garvsify/Nixie-Valve-Clock/README.md

# Nixie-Valve-Clock
All files for the Nixie Valve Clock Project. Started 04/11/2025
