garvsify/Nixie-Valve-Clock/Electronic Resources and References/PCB Source Files/A.2-Release-(A.1-with-changes-documentation)/Nixie Valve Clock-A.2/SRC-Nixie Valve Clock-A.2/Eurocircuits Class Calculator and Design Rule Generator.xlsx

 |  |  |  |  | Eurocircuits Classifications
User Guide |  |  |  |  | Pattern Class | MUAR (mm)(Minimum of MUOAR/MUIAR) | MTW (mm) | MTT/MTP/MPP (mm)
 |  |  |  |  | 3 | 0.2 | 0.25 | 0.25
Enter MPS, PTH/NPTH, and MFHS into the green-outlined cells to calculate Pattern and Drill Classes |  |  |  |  | 4 | 0.15 | 0.2 | 0.2
 |  |  |  |  | 5 | 0.15 | 0.175 | 0.175
 |  |  |  |  | 6 | 0.125 | 0.15 | 0.15
Note: The minimum hole-to-hole clearances listed in the 'Altium Design Rule Generator' are essentially exception rules if the minimum pad-to-pad and minimum annular ring rules are broken. I.e. if the annular rings are shrunk below the minimum (this is legal in certain cases, see Eurocircuits website) then this is where the minimum hole-to-hole clearance becomes relevant |  |  |  |  | 7 | 0.125 | 0.125 | 0.125
 |  |  |  |  | 8 | 0.125 | 0.1 | 0.1
 |  |  |  |  | 9 | 0.1 | 0.09 | 0.09
 |  |  |  |  | Drill Class | MTS (mm)
Glossary |  | Equations |  |  | A | 0.6
MTS | Minimum Toolsize | If PTH: |  |  | B | 0.45
MUAR | Minimum Unfinished Annular Ring | MFAR = MUAR + (0.1/2)mm |  |  | C | 0.35
MUIAR | Minimum Unfinished Inner Annular Ring |  |  |  | D | 0.25
MUOAR | Minimum Unfinished Outer Annular Ring | If NPTH: |  |  | E | 0.2
MTW | Minimum Track Width | MFAR = MUAR
MTT | Minimum Track-to-Track Clearance |  |  |  | Minimum Class Calculator
MTP | Minimum Track-to-Pad Clearance | If PTH:
MPP | Minimum Pad-To-Pad Clearance | MFHS = MTS - 0.1mm |  |  | Minimum Pattern Class:
MUHH | Minimum Unfinished Hole-to-Hole Clearance |  |  |  | Note: PTH will require a smaller (higher number) Pattern class due to the larger toolsize compared with NPTH, therefore advice is to plug in your smallest PTH characteristics to find your minimum Pattern Class. However because for the same MFHS, NPTH will require a smaller toolsize, if you are using NPTH in your design, and the NPTH MFHS less than or equal to the PTH MFHS, remember to plug these values in to find the smallest Drill Class in your project
MFHH | Minimum Finished Hole-to-Hole Clearance | If NPTH:
MFAR | Minimum Finished Annular Ring | MFHS = MTS |  |  | Enter MPS required | Enter PTH/NPTH | Enter MFHS required | (Calculated Ideal MUAR) | (Calculated Nearest Class MUAR) | (Calculated MFAR in calculated class) | Calculate Minimum Pattern Class
MFHS | Minimum Finished Hole Size |  |  |  | 0.8 | PTH | 0.4 | 0.15 | 0.15 | 0.2 | 4
MTS | Minimum Toolsize
MPS | Minimum Padsize |  |  |  | Minimum Drill Class:
PTH | Plated Through Hole |  |  |  | PTH/NPTH | MFHS | (Calculated Ideal MTS) | (Calculated Nearest Class MTS) | Calculate Minimum Drill Class
NPTH | Non-Plated Through Hole |  |  |  | PTH | 0.4 | 0.5 | 0.45 | B
 |  |  | Rules generated for Class: |  | Altium Design Rule Generator (from Calculator)
 |  |  | 4 | B | Note: You may have to create new rules
 |  |  |  |  | Design Rule Location | Design Rule | Amount (mm)
 |  |  |  |  | Electrical > Clearance | Minimum Clearance | 0.2
 |  |  |  |  | Electrical > Clearance | Clearance_IPI | 0.225
 |  |  |  |  | Routing > Width | Minimum Width | 0.2
 |  |  |  |  | Routing > Routing Via Style | Routing Vias | *
 |  |  |  |  | Mask > Solder Mask Expansion | Solder Mask Expansion | 0.04
 |  |  |  |  | Mask > Paste Mask Expansion | Paste Mask Expansion | 0
 |  |  |  |  | Manufacturing | PTH Minimum Annular Ring (PTH MFAR) | 0.2
 |  |  |  |  | Manufacturing | NPTH Minimum Annular Ring (NPTH MFAR) | 0.15
 |  |  |  |  | Manufacturing | Minimum Hole Size PTH (PTH MFHS) | 0.4
 |  |  |  |  | Manufacturing | Minimum Hole Size NPTH (NPTH MFHS) | 0.5
 |  |  |  |  | Manufacturing | Minimum Hole to Hole Clearance | 0.35
 |  |  |  |  | Manufacturing | Minimum Soldermask Sliver | 0.08
 |  |  |  |  | Manufacturing | Silk to Soldermask Clearance | 0
 |  |  |  |  | Manufacturing | Silk to Silk Clearance | 0.15
 |  |  |  |  | Manufacturing | Board Outline Clearance** | 0.4
 |  |  |  |  | * Set your minimum characteristics for the routing vias to the MPS and MFHS, set the pref. and max. relevant to your own projwct requirements
 |  |  |  |  | ** As The board outline is intepreted as an 'object' the actual Board outline clearance will be the largest of the Board Outline Clearance Rule and a specific region to the board outline region (controlled from the clearance rules), so make sure your clearance rule accounts for this placing regions up to the board outline
 |  |  | Enter Class: |  | Altium Design Rule Generator (Manual Class Selection)
 |  |  | 9 | D | Note: You may have to create new rules
 |  |  |  |  | Design Rule Location | Design Rule | Amount (mm)
 |  |  |  |  | Electrical > Clearance | Minimum Clearance | 0.09
 |  |  |  |  | Electrical > Clearance | Clearance_IPI | 0.2
 |  |  |  |  | Routing > Width | Minimum Width | 0.09
 |  |  |  |  | Routing > Routing Via Style | Routing Vias | *
 |  |  |  |  | Mask > Solder Mask Expansion | Solder Mask Expansion | 0.04
 |  |  |  |  | Mask > Paste Mask Expansion | Paste Mask Expansion | 0
 |  |  |  |  | Manufacturing | PTH Minimum Annular Ring (PTH MFAR) | 0.15
 |  |  |  |  | Manufacturing | NPTH Minimum Annular Ring (NPTH MFAR) | 0.1
 |  |  |  |  | Manufacturing | Minimum Hole Size PTH (PTH MFHS) | 0.15
 |  |  |  |  | Manufacturing | Minimum Hole Size NPTH (NPTH MFHS) | 0.25
 |  |  |  |  | Manufacturing | Minimum Hole to Hole Clearance | 0.35
 |  |  |  |  | Manufacturing | Minimum Soldermask Sliver | 0.08
 |  |  |  |  | Manufacturing | Silk to Soldermask Clearance | 0
 |  |  |  |  | Manufacturing | Silk to Silk Clearance | 0.15
 |  |  |  |  | Manufacturing | Board Outline Clearance** | 0.4
 |  |  |  |  | * Minimum characteristics for vias/pads can be derived from other rules
 |  |  |  |  | ** As The board outline is intepreted as an 'object' the actual Board outline clearance will be the largest of the Board Outline Clearance Rule and a specific region to the board outline region (controlled from the clearance rules), so make sure your clearance rule accounts for this placing regions up to the board outline
