garvsify/Nixie-Valve-Clock/Cathode Poisoning/Screenshot 2025-11-05 at 15.28.37.png

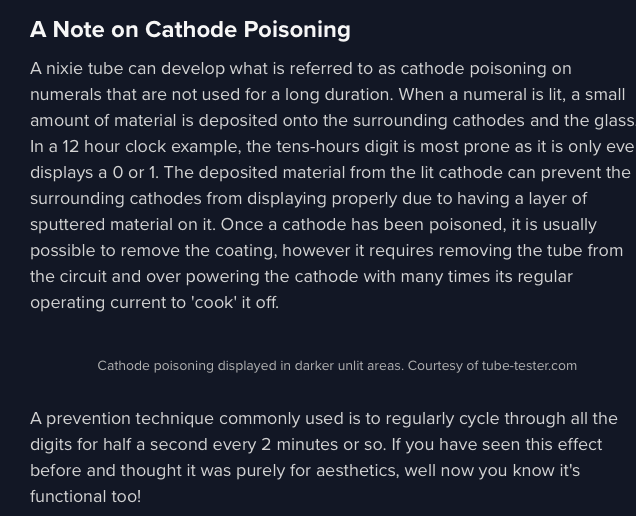
Cathode Poisoning/Screenshot 2025-11-05 at 15.28.37.png
