garvsify/Nixie-Valve-Clock/Electronic Resources and References/IN-35 Nixie Tube Resources/IN-35 eBay listing details.png

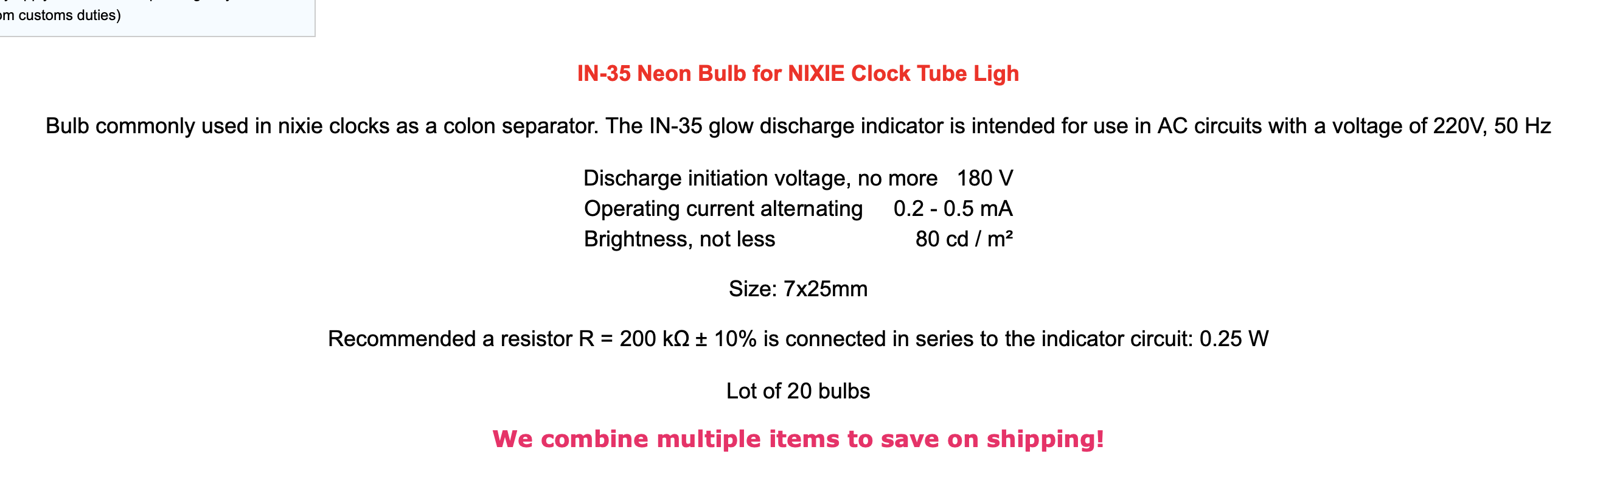
Electronic Resources and References/IN-35 Nixie Tube Resources/IN-35 eBay listing details.png
