garvsify/Nixie-Valve-Clock/Electronic Resources and References/Rotary Encoder/DPL12SV Rotary encoder dimensions.png

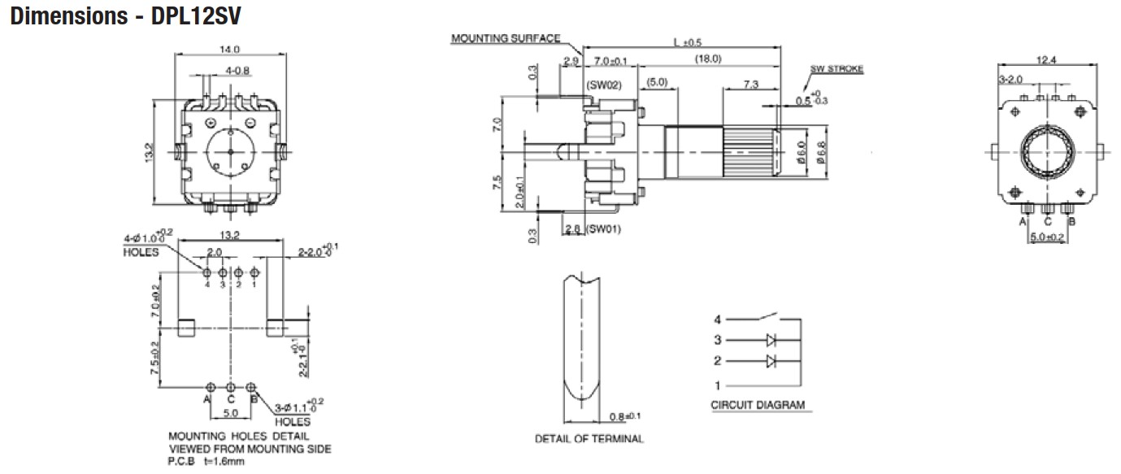
Electronic Resources and References/Rotary Encoder/DPL12SV Rotary encoder dimensions.png
