garvsify/Nixie-Valve-Clock/Fusion Design Files/Nixie Clock Drawing 2.png

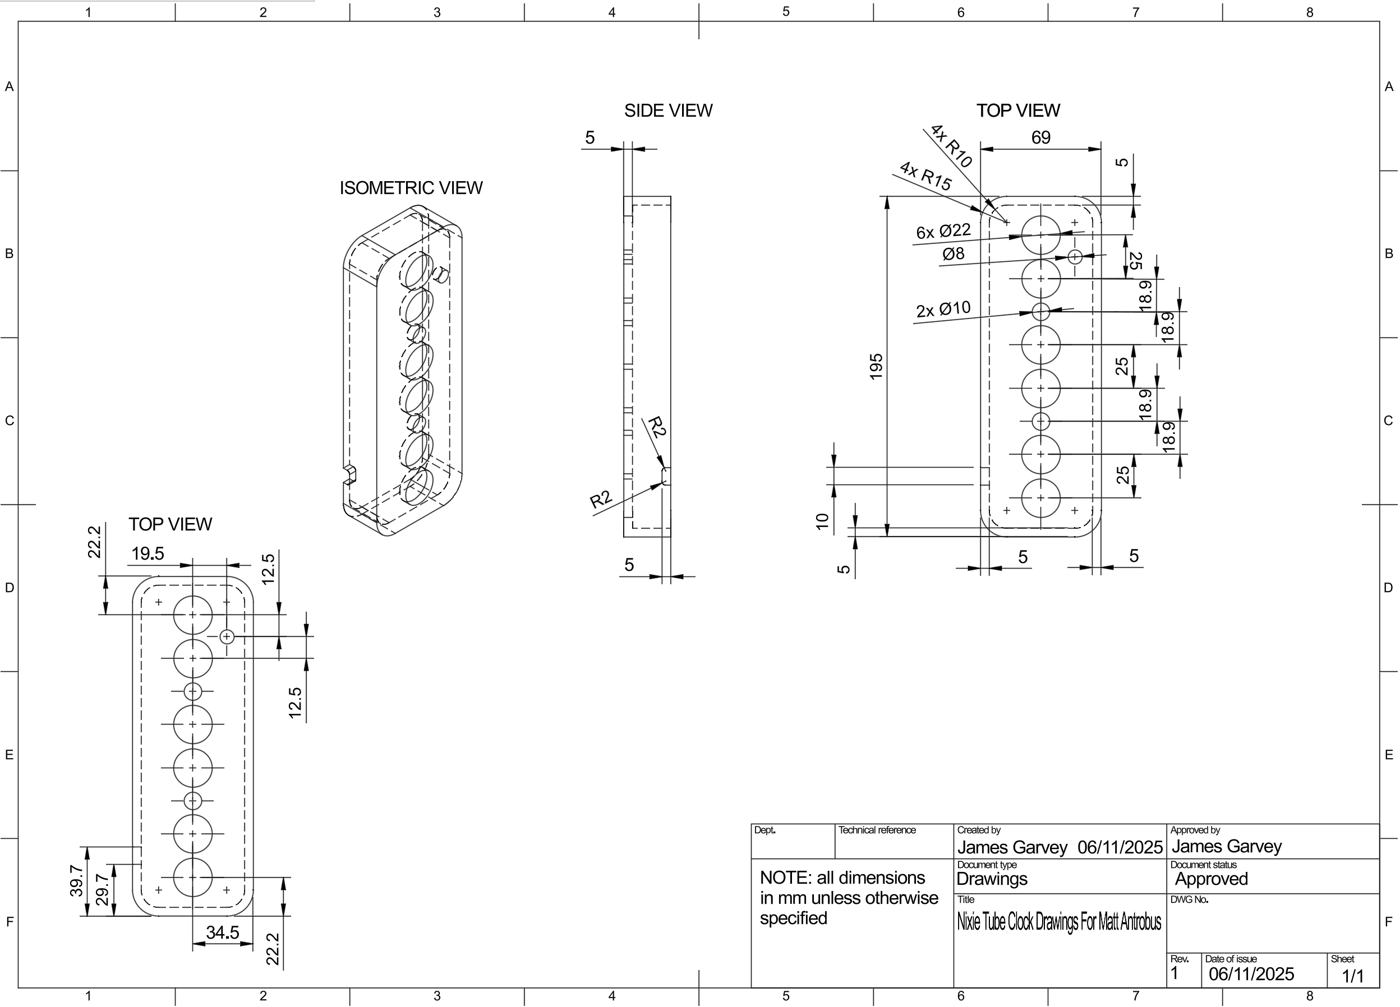
Fusion Design Files/Nixie Clock Drawing 2.png
