garvsify/Nixie-Valve-Clock/Inspo/Screenshot 2025-11-05 at 10.26.48.png

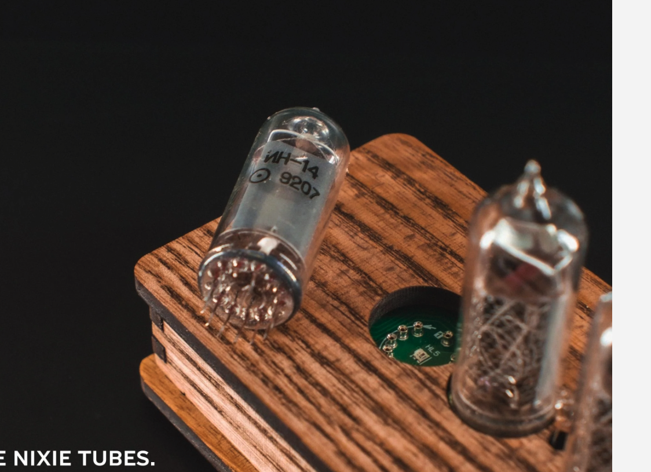
Inspo/Screenshot 2025-11-05 at 10.26.48.png
