garvsify/Nixie-Valve-Clock/Inspo/Screenshot 2025-11-05 at 16.18.10.png

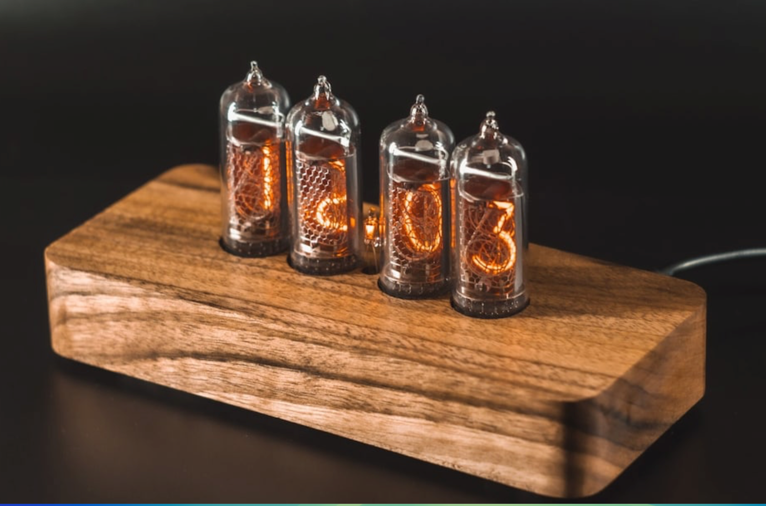
Inspo/Screenshot 2025-11-05 at 16.18.10.png
