garvsify/Nixie-Valve-Clock/Electronic Resources and References/Buzzer Files/Same_Sky_CMI-1271-85-SMT-TR/BOM.txt

3DX_Same_Sky_Supplier: Same Sky
3DX_Same_Sky_Description: 12.8 mm, 12 Vdc, 85 dB, Surface Mount (SMT), Driving Circuit, Magnetic Audio Indicator Buzzer
3DX_Same_Sky_Model Number: CMI-1271-85-SMT-TR
