garvsify/Nixie-Valve-Clock/BOMs/Nixie Valve Clock Power Supply Daughterboard_EUROCIRCUITS_BOM.xlsx

Line # | Name | Description | Designator | Quantity | Manufacturer 1 | Manufacturer Part Number 1 | Manufacturer Lifecycle 1 | Supplier 1 | Supplier Part Number 1 | Supplier Unit Price 1 | Supplier Subtotal 1
 | CC0805KKX7RYBB104 | Ceramic Capacitor, Ceramic, 250V, 10% +Tol, 10% -Tol, X7R, 15% TC, 0.1uF, Surface Mount, 0805 | C1 | 1 | Yageo Group | CC0805KKX7RYBB104 | Volume Production | Mouser | 603-C0805KKX7RYBB104 | 0.12 | 0.12
 | TPSD107M016R0125 | Cap Tant Solid 100uF 16V D CASE 20% (7.3 X 4.3 X 2.9mm) SMD 7343-31 0.125 Ohm 125A HA T/R | C2 | 1 | KYOCERA AVX | TPSD107M016R0125 | Volume Production | Mouser | 581-TPSD107M016R0125 | 1.34 | 1.34
 | CGA8P3X7T2E105K250KA | CGA Series 1812 1 uF 250 V ±10 % Tolerance X7T SMT Multilayer Ceramic Capacitor | C3, C4, C5, C6, C7, C8 | 6 | TDK | CGA8P3X7T2E105K250KA | Volume Production | Mouser | 810-CGA8P3X7T2E105K | 0.64 | 6.4
 | CC0805KKX7RYBB104 | Ceramic Capacitor, Ceramic, 250V, 10% +Tol, 10% -Tol, X7R, 15% TC, 0.1uF, Surface Mount, 0805 | C9 | 1 | Yageo Group | CC0805KKX7RYBB104 | Volume Production | Mouser | 603-C0805KKX7RYBB104 | 0.12 | 0.12
 | TPSD106K035R0300 | Capacitor Tantalum Solid 10uF 35V D CASE 10% (7.3 X 4.3 X 2.9mm) SMD 7343-31 0.3 Ohm 125C T/R | C10 | 1 | KYOCERA AVX | TPSD106K035R0300 | Volume Production | Mouser | 581-TPSD106K035R0300 | 1.75 | 1.75
 | CGA3E2X7R1H104K080AA | Ceramic Capacitor, Multilayer, Ceramic, 50V, 10% +Tol, 10% -Tol, X7R, 15% TC, 0.1uF, Surface Mount, 0603 | C11, C12, C14, C15 | 4 | TDK | CGA3E2X7R1H104K080AA | Volume Production | Mouser | 810-CGA3E2X7R1H104K | 0.031 | 0.31
 | C1608X7R1H334K080AC | Ceramic Capacitor, Multilayer, Ceramic, 50V, 10% +Tol, 10% -Tol, X7R, 15% TC, 0.33uF, Surface Mount, 0603 | C13 | 1 | TDK | C1608X7R1H334K080AC | Not Recommended for New Design | Mouser | 810-C1608X7R1H334K | 0.19 | 0.19
 | ES2F-E3/5BT | Rectifier Diode, 1 Phase, 1 Element, 2A, 300V V(RRM), Silicon, DO-214AA | D1 | 1 | Vishay | ES2F-E3/5BT | Volume Production | Mouser | 625-ES2F-E3/5BT | 0.54 | 0.54
 | 1PMT4135E3/TR7 | Diode Zener Single 100V 5% 1W 2-Pin(1+Tab) Power Mite T/R | D2 | 1 | Microchip | 1PMT4135E3/TR7 | Volume Production | Mouser | 494-1PMT4135E3/TR7 | 0.46 | 0.46
 | SS54BF-HF | Rectifier Diode, Schottky, 1 Phase, 1 Element, 5A, 40V V(RRM), Silicon | D3 | 1 | Comchip | SS54BF-HF | Volume Production | Mouser | 750-SS54BF-HF | 0.74 | 0.74
 | FTS-120-02-L-DV | Pin Header, Board-to-Board, 1.27 mm, 2 Rows, 40 Contacts, Surface Mount, FTS Series | J1, J2 | 2 | Samtec | FTS-120-02-L-DV | Volume Production | Mouser | 200-FTS12002LDV | 4.49 | 8.98
 | 694106301002 | DC Power Jack Connector WR-DC, Male, Right Angled, THT, 5 A, 24 V | J3 | 1 | Wurth Elektronik | 694106301002 | Unknown | Mouser | 710-694106301002 | 0.877 | 0.877
 | SRR1280-101M | Inductor Power Shielded Wirewound 100uH 20% 1KHz 18Q-Factor Ferrite 2.1A 0.15Ohm DCR T/R | L1 | 1 | Bourns | SRR1280-101M | Volume Production | Mouser | 652-SRR1280-101M | 1.01 | 1.01
 | BC807-25WT1G | Small Signal Bipolar Transistor, 0.5A I(C), 45V V(BR)CEO, 1-Element, PNP, Silicon | Q1 | 1 | onsemi | BC807-25WT1G | Volume Production | Mouser | 863-BC807-25WT1G | 0.155 | 0.155
 | BSP317PH6327XTSA1 | MOSFET P-CH 250V 430MA SOT223-4 P-Channel 250 V 430mA (Ta) 1.8W (Ta) Surface Mount PG-SOT223-4 | Q2 | 1 | Infineon | BSP317PH6327XTSA1 | Volume Production | Mouser | 726-BSP317PH6327XTSA | 1.14 | 1.14
 | STD18NF25 | N-Channel 250 V 0.165 Ohm Surface Mount STripFet II Power MosFet - TO-252-3 | Q3 | 1 | STMicroelectronics | STD18NF25 | Volume Production | Mouser | 511-STD18NF25 | 2.24 | 2.24
 | SI4459BDY-T1-GE3 | Transistor MOSFET P-CH 30V 27.8A 8-Pin SOIC | Q4 | 1 | Vishay | SI4459BDY-T1-GE3 | Volume Production | Mouser | 78-SI4459BDY-T1-GE3 | 1.54 | 1.54
 | BC817-25-TP | Small Signal Bipolar Transistor, 0.5A I(C), 45V V(BR)CEO, 1-Element, NPN, Silicon | Q5 | 1 | MCC | BC817-25-TP | Volume Production | Mouser | 833-BC817-25-TP | 0.095 | 0.095
 | AC0603FR-077R5L | Res Thick Film 0603 7.5 Ohm 1% 0.1W(1/10W) ±200ppm/C Pad SMD T/R Automotive AEC-Q200 | R2 | 1 | Yageo Group | AC0603FR-077R5L | Volume Production | Mouser | 603-AC0603FR-077R5L | 0.1 | 0.1
 | CRMA2010AF1M50FKEF | Fixed Resistor, Metal Glaze/thick Film, 0.5W, 1.5e+06ohm, 2000V, 1% +/-Tol, 100ppm/Cel, Surface Mount, 2010 | R4 | 1 | Vishay | CRMA2010AF1M50FKEF | Volume Production | Mouser | 71-CRMA2010AF1M50FKF | 1.12 | 1.12
 | CRCW2010200KFKEF | Res Thick Film 2010 200K Ohm 1% 0.75W(3/4W) ±100ppm/C Pad SMD Automotive T/R | R5 | 1 | Vishay | CRCW2010200KFKEF | Volume Production | Mouser | 71-CRCW2010-200K-E3 | 0.23 | 0.23
 | ERJ-3EKF5601V | Fixed Resistor, Metal Glaze/thick Film, 0.1W, 5600ohm, 75V, 1% +/-Tol, 100ppm/Cel, Surface Mount, 0603 | R6 | 1 | Panasonic | ERJ-3EKF5601V | Volume Production | Mouser | 667-ERJ-3EKF5601V | 0.12 | 0.12
 | Resistor 4k7 +/-1% 0603 100 mW | Chip Resistor, 4.7 KOhm, +/- 1%, 0.1 W, -55 to 155 degC, 0603 (1608 Metric) | R7, R15 | 2 | Yageo Group | RC0603FR-134K7L | Volume Production | Mouser | 603-RC0603FR-134K7L | 0.007 | 0.07
 | Resistor 10k +/-1% 0805 125 mW | Chip Resistor, 10 KOhm, +/- 1%, 125 mW, -55 to 155 degC, 0805 (2012 Metric) | R8, R12 | 2 | Yageo Group | RC0805FR-0710KL | Volume Production | Mouser | 603-RC0805FR-0710KL | 0.012 | 0.12
 | RL1210FR-070R025L | Fixed Resistor, Metal Glaze/thick Film, 0.5W, 0.025ohm, 0.1118V, 1% +/-Tol, 1000ppm/Cel, Surface Mount, 1210 | R9 | 1 | Yageo Group | RL1210FR-070R025L | Volume Production | Mouser | 603-RL210FR-070R025L | 0.51 | 0.51
 | 5-2176347-6 | Res Thick Film 2010 390K Ohm 1% 0.75W(3/4W) ±100ppm/C Pad SMD Automotive T/R | R11 | 1 | TE Connectivity / AMP | 5-2176347-6 | Volume Production | Mouser | 279-CRGCQ2010F390K | 0.26 | 0.26
 | CRCW1206150KFKEA | Fixed Resistor, Metal Glaze/thick Film, 0.25W, 150000ohm, 200V, 1% +/-Tol, 100ppm/Cel, Surface Mount, 1206 | R13 | 1 | Vishay | CRCW1206150KFKEAHP | Volume Production | Mouser | 71-CRCW1206150KFKEAH | 0.28 | 0.28
 | CRCW1210470RFKEAHP | Res Thick Film 1210 470 Ohm 1% 0.75W(3/4W) ±100ppm/C Pad SMD Automotive T/R | R14 | 1 | Vishay | CRCW1210470RFKEAHP | Volume Production | Mouser | 71-CRCW1210470RFKEAH | 0.31 | 0.31
 | 3266W-1-502LF | Cermet trimmer potentiometer, 12 turns, 5 kΩ, 0.25 W, THT, on top, 3266W-1-502LF | TR1 | 1 | Bourns | 3266W-1-502LF | Volume Production | Mouser | 652-3266W-1-502LF | 2.67 | 2.67
 | MAX1771CSA+ | DC-DC Switching Boost (Step Up) Regulator, Adjustable, 2 V-16.5 Vin, 2V-12Vout, 2Aout, SOIC-8 | U1 | 1 | Analog Devices | MAX1771CSA+ | Volume Production | Mouser | 700-MAX1771CSA | 6.2 | 6.2
 | MCP6541RT-I/OT | Comparator Single R-R I/O 5.5V 5-Pin SOT-23 T/R Automotive AEC-Q100 | U2 | 1 | Microchip | MCP6541RT-I/OT | Volume Production | Mouser | 579-MCP6541RT-I/OT | 0.39 | 0.39
 | UA78M33CDCYG3 | Standard Regulator Pos 3.3V 0.5A 4-Pin(3+Tab) SOT-223 Tube | U3 | 1 | Texas Instruments | UA78M33CDCYG3 | Volume Production | Mouser | 595-UA78M33CDCYG3 | 1.14 | 1.14
