garvsify/Nixie-Valve-Clock/BOMs/Nixie Valve Clock Rotary Encoder Daughterboard_EUROCIRCUITS_BOM.xlsx

Line # | Name | Description | Designator | Quantity | Manufacturer 1 | Manufacturer Part Number 1 | Manufacturer Lifecycle 1 | Supplier 1 | Supplier Part Number 1 | Supplier Unit Price 1 | Supplier Subtotal 1
 | 4-1879314-5 | Incremental Encoder, Mechanical, 24Ppr Rohs Compliant: Yes |Citec Te Connectivity 4-1879314-5 | E1 | 1 | TE Connectivity / AMP | 4-1879314-5 | Volume Production | Mouser | 279-DPL12SV2424A25K3 | 10.62 | 10.62
 | 61200621621 | Board Connector, 6 Contact(s), 2 Row(s), Male, Straight, Solder Terminal | P1 | 1 | Wurth Elektronik | 61200621621 | Unknown | Mouser | 710-61200621621 | 0.404 | 0.404
