garvsify/Nixie-Valve-Clock/BOMs/Nixie Valve Clock_EUROCIRCUITS_BOM.xlsx

Line # | Name | Description | Designator | Quantity | Manufacturer 1 | Manufacturer Part Number 1 | Manufacturer Lifecycle 1 | Supplier 1 | Supplier Part Number 1 | Supplier Unit Price 1 | Supplier Subtotal 1
 | MI-SMT09-0327-SK | Magnetic Indicator SMT 9.6MM 3V | B1 | 1 | VCC | MI-SMT09-0327-SK | Unknown | Mouser | 593-MI-SMT09-0327-SK | 3.27 | 3.27
 | CGA3E2X7R1H104K080AA | Ceramic Capacitor, Multilayer, Ceramic, 50V, 10% +Tol, 10% -Tol, X7R, 15% TC, 0.1uF, Surface Mount, 0603 | C1, C2, C3, C4 | 4 | TDK | CGA3E2X7R1H104K080AA | Volume Production | Mouser | 810-CGA3E2X7R1H104K | 0.031 | 0.31
 | 06036D476MAT2A | 0603 (1608Metric) CERAMIC CAPACITOR ceramic capacitor 6.3V 47uF ±20% X5R | C5 | 1 | KYOCERA AVX | 06036D476MAT2A | Volume Production | Mouser | 581-06036D476MAT2A | 0.51 | 0.51
 | C0603X150J5GACTU | Cap Ceramic 15pF 50V C0G 5% Pad SMD 0603 Flexible Termination 125C Extreme Low ESR T/R | C6, C7 | 2 | KEMET | C0603X150J5GACTU | Volume Production | Mouser | 80-C0603X150J5G | 0.33 | 0.66
 | IN-S85AT5UW | SMD LED - Mono Color Top View, 805 1.1mm LED PCB Type, White, High Brightness, Clear Lens, Angle 120 | D3A, D3B, D3C, D3D, D3E, D3F | 6 | Inolux | IN-S85AT5UW | Unknown | Mouser | 743-IN-S85AT5UW | 0.22 | 1.32
 | FLE-120-01-G-DV | PCB Receptacle, Board-to-Board, Wire-to-Board, 1.27 mm, 2 Rows, 40 Contacts, Surface Mount | J1, J2 | 2 | Samtec | FLE-120-01-G-DV | Volume Production
 | N2506-6V0C-RB-WD | 80001386988 N2506-6V0C-Rb-Wd=06//Ht/Vsmt/30U/Rohs/Cap/T&r |3M N2506-6V0C-RB-WD | J3 | 1 | 3M | N2506-6V0C-RB-WD | Volume Production | Mouser | 517-N2506-6V0C-RB-WD | 4.35 | 4.35
 | FTSH-107-01-L-DV-K-A | Conn Unshrouded Header HDR 14 POS 1.27mm Solder ST Top Entry SMD TIGER CLAW™ Tube | J4 | 1 | Samtec | FTSH-107-01-L-DV-K-A | Volume Production | Mouser | 200-FTSH10701LDVKA | 3.21 | 3.21
 | MMBTA42LT1G | Bipolar (BJT) Single Transistor, General Purpose, NPN, 300 V, 500 mA, 225 mW, SOT-23, Surface Mount | Q1, Q3A, Q3B, Q3C, Q3D, Q3E, Q3F, Q4A, Q4B, Q4C, Q4D, Q4E, Q4F, Q5A, Q5B, Q5C, Q5D, Q5E, Q5F, Q5G, Q5H, Q5I, Q5J, Q6A, Q6B, Q6C, Q6D, Q6E, Q6F, Q7A, Q7B | 31 | onsemi | MMBTA42LT1G | Volume Production | Mouser | 863-MMBTA42LT1G | 0.113 | 3.5
 | Resistor 4k7 +/-1% 0603 100 mW | Chip Resistor, 4.7 KOhm, +/- 1%, 0.1 W, -55 to 155 degC, 0603 (1608 Metric) | R1, R2, R3, R4, R5, R6, R7, R8, R21A, R21B, R21C, R21D, R21E, R21F, R23A, R23B, R23C, R23D, R23E, R23F, R23G, R23H, R23I, R23J, R25A, R25B, R25C, R25D, R25E, R25F, R27A, R27B | 32 | Yageo Group | RC0603FR-134K7L | Volume Production | Mouser | 603-RC0603FR-134K7L | 0.007 | 0.224
 | ERJ-3EKF1000V | Fixed Resistor, Metal Glaze/thick Film, 0.1W, 100ohm, 75V, 1% +/-Tol, 100ppm/Cel, Surface Mount, 0603 | R9 | 1 | Panasonic | ERJ-3EKF1000V | Volume Production | Mouser | 667-ERJ-3EKF1000V | 0.086 | 0.086
 | CRCW0603150RFKEAHP | Res Thick Film 0603 150 Ohm 1% 1/3W ±100ppm/°C Molded SMD SMD Paper T/R | R10, R11 | 2 | Vishay | CRCW0603150RFKEAHP | Volume Production | Mouser | 71-CRCW0603150RFKEAH | 0.129 | 0.258
 | CRGCQ1210F100K | Res Thick Film 1210 100K Ohm 1% 0.5W(1/2W) ±100ppm/C Pad SMD Automotive T/R | R18A, R18B, R18C, R18D, R18E, R18F | 6 | TE Connectivity | CRGCQ1210F100K | Volume Production | Mouser | 279-CRGCQ1210F100K | 0.081 | 0.81
 | ERJP14F1303U | Res Thick Film 1210 130K Ohm 1% 0.5W ±100ppm/°C Molded SMD Embossed Carrier T/R | R19A, R19B, R19C, R19D, R19E, R19F, R22A, R22B, R22C, R22D, R22E, R22F, R22G, R22H, R22I, R22J | 16 | Panasonic | ERJP14F1303U | Volume Production | Mouser | 667-ERJ-P14F1303U | 0.213 | 3.41
 | CRGCQ1210F4K7 | Res Thick Film 1210 4.7K Ohm 1% 0.5W(1/2W) ±100ppm/C Pad SMD T/R Automotive AEC-Q200 | R20A, R20B, R20C, R20D, R20E, R20F | 6 | TE Connectivity | CRGCQ1210F4K7 | Volume Production | Mouser | 279-CRGCQ1210F4K7 | 0.079 | 0.79
 | ERJ-3EKF33R0V | Fixed Resistor, Metal Glaze/thick Film, 0.1W, 33ohm, 75V, 1% +/-Tol, 100ppm/Cel, Surface Mount, 0603 | R24A, R24B, R24C, R24D, R24E, R24F | 6 | Panasonic | ERJ-3EKF33R0V | Volume Production | Mouser | 667-ERJ-3EKF33R0V | 0.021 | 0.21
 | SG73P2ETTD3003F | Fixed Resistor, Metal Glaze/thick Film, 1.5W, 300000ohm, 200V, 1% +/-Tol, 200ppm/Cel, Surface Mount, 1210 | R26A, R26B | 2 | KOA Speer | SG73P2ETTD3003F | Volume Production | Mouser | 660-SG73P2ETTD3003F | 0.29 | 0.58
 | CD4028BPWR | CMOS BCD-to-Decimal or Binary-to-Octal Decoders/Drivers 16-TSSOP -55 to 125 | U1 | 1 | Texas Instruments | CD4028BPWR | Volume Production | Mouser | 595-CD4028BPWR | 0.53 | 0.53
 | STM32G031K8T6 | RISC Microcontroller, 32-Bit, FLASH, CORTEX-M0 CPU, 64MHz, CMOS, PQFP32 | U2 | 1 | STMicroelectronics | STM32G031K8T6 | Volume Production | Mouser | 511-STM32G031K8T6 | 2.86 | 2.86
 | IN-14 | IN-14 Cold Cathode Valve | V1A, V1B, V1C, V1D, V1E, V1F | 6
 | IN-3 | IN-3 Cold Cathode Indicator Valve | V2A, V2B | 2
 | NX3215SA-32.768K-STD-MUS-2 | Crystal 0.032768MHz ±20ppm (Tol) 12.5pF FUND 80000Ohm Automotive AEC-Q200 2-Pin SMD | X1 | 1 | NDK | NX3215SA-32.768K-STD-MUS-2 | Volume Production | Mouser | 344-NX3215SA32768K2 | 0.585 | 0.585
