garvsify/Nixie-Valve-Clock/Inspo/Nixieclock_kit-main/Nixieclock_kit_2v1_bom.ods

BOM
Item | Qty | Reference(s) | Value | Reichelt | manf#
1 | 1 | 68uH1 | INDUCTOR | WUE 7447709680 | 7447709680
2 | 1 | BT401 | Battery_Cell |  | BAT-HLD-012-SMT
3 | 14 | C1, C5, C6, C8, C14, C16, C17, C18, C19, C20, C21, C22, C23, C201 | 2.2u | KEM X5R0805 2,2U | C0805C225K8PACTU
4 | 3 | C2, C3, C4 | 22u | X5R-G0805 22/6 | GRM21BR60J226ME39L
5 | 1 | C7 | 150p | KEM C0G0805 150P | C0805C151J5GACTU
6 | 1 | C9 | 1n | KEM C0G0805 150P | C0805C151J5GACTU
7 | 2 | C12, C13 | 1u |  | 2225PC105MAT1A
8 | 1 | C305 | 3n3 | KEM X7R0805 3,3N | C0805C151J5GACTU
9 | 1 | D1 | P6SMB6,8A | P6SMB 6,8A SMD | P6SMB6,8A
10 | 1 | D2 | PRTR5V0U2X |  | PRTR5V0U2X,215
11 | 1 | D304 | ES2G/SMB | ES 2G SMD | ES2G-E3/52T
12 | 1 | D401 | TX | SMD-LED 0805 RT | KP-2012ID
13 | 1 | D402 | RX | SMD-LED 0805 GN | KP-2012SGD
14 | 1 | F1 | 2,2A | LITT MINISMDC110 | MINISMDC110F/24-2
15 | 4 | FID1, FID2, FID3, FID4 | Fiducial | n.b. | n.b.
16 | 4 | H1, H2, H3, H4 | MountingHole | n.b. | n.b.
17 | 1 | J1 | Conn_01x06_Male | n.b. | n.b.
18 | 1 | L4 | Ferrite_Bead | BLM21PG 331 | BLM21PG331 SN1D
19 | 4 | LED401, LED402, LED403, LED404 | WS2812B
20 | 1 | NT1 | Net-Tie_2 | n.b. | n.b.
21 | 1 | P301 | USB_OTG | USB BWM SMD | USB BWM SMD
22 | 1 | Q1 | SI4434 | SI4434DY-GE3 | SI4434DY-T1-GE3
23 | 1 | Q2 | BSS138 | BSS 138 SMD | BSS 138 SMD
24 | 8 | Q202, Q203, Q204, Q205, Q206, Q207, Q208, Q209 | MPSA92 | MPSA 92 | MPSA92
25 | 3 | Q401, Q403, Q404 | BSS138 | BSS 138 SMD | BSS 138 SMD
26 | 1 | R1 | 68k1 | RND 0805 1 68K | RND1550805S8F6802T5E
27 | 18 | R2, R3, R206, R310, R401, R402, R403, R410, R411, R412, R413, R414, R416, R417, R418, R419, R420, R421 | 10k | RND 0805 1 10K | RND1550805S8F1002T5E
28 | 1 | R4 | 51k1 | RND 0805 1 51K | RND1550805S8F5102T5E
29 | 1 | R5 | 1k | RND 0805 1 51K | RND1550805S8F5102T5E
30 | 4 | R201, R203, R205, R208 | 330k | VI MBB02070C3303 | MBB02070C3303FCT00
31 | 4 | R202, R204, R207, R209 | 330 | VI MBB02070C3300 | MBB02070C3300FCT00
32 | 1 | R308 | 1M5 | SMD-0805 1,50M | RC0805FR-071M5L
33 | 4 | R404, R405, R406, R407 | 10R | RND 0805 1 10 | RND1550805S8F100JT5E
34 | 2 | R408, R409 | 120 | RND 0805 1 120 | RND1550805S8F1200T5E
35 | 1 | R415 | R_PHOTO | n.b. | n.b.
36 | 1 | RSENSE301 | 0R050 | PAN ERJ8CWFR050 | ERJ-L14KF50MU
37 | 1 | SW1 | EG1224 |  | EG1224
38 | 1 | SW401 | SW_Push | RND 210-00192 | RND 210-00192
39 | 1 | SW402 | Rechts | RND 210-00258 | RND 210-00258
40 | 1 | SW403 | Mitte | RND 210-00258 | RND 210-00258
41 | 1 | SW404 | Links | RND 210-00258 | RND 210-00258
42 | 4 | TBE201, TBE202, TBE203, TBE204 | IN14
43 | 1 | U1 | DS3231MZ |  | DS3231MZ+
44 | 1 | U2 | LM1117-3.3 | LM 1117 IDT-3.3 | LM1117IDT-3.3/NOPB
45 | 1 | U3 | LM3478 | LM 3478 MM | LM3478MM/NOPB
46 | 2 | U201, U202 | HV5530 bzw HV5522 |  | HV5522PG-G
47 | 1 | U401 | ESP-12E | DEBO ESP8266-12F | ESP-12S
48 | 1 | U402 | FT232RL | FT 232 RL | FT232RL-REEL
49 | 1 | U403 | MCP23008 |  | MCP23008-E/SO
50 | 2 | W401, W402 | TEST_2P | n.b. | n.b.
