garvsify/Nixie-Valve-Clock/Electronic Resources and References/PCB Source Files/A.2-Release-(A.1-with-changes-documentation)/Rotary Encoder DTB-A.2/ASM-Nixie Valve Clock Rotary Encoder Daughterboard-[NO VARIATIONS]-A.2/Assembly/BOM JLCPCB/Nixie Valve Clock Rotary Encoder Daughterboard_JLCPCB_BOM.csv

Manufacturer Part Number 1 | Designator | Footprint | Quantity
4-1879314-5 | E1 | 4-1879314-5-Footprint-1 | 1
61200621621 | P1 | 61200621621 | 1
