garvsify/Nixie-Valve-Clock/Inspo/IoT-nixie-clock-master/3DCase/CaseAssembly.SLDASM

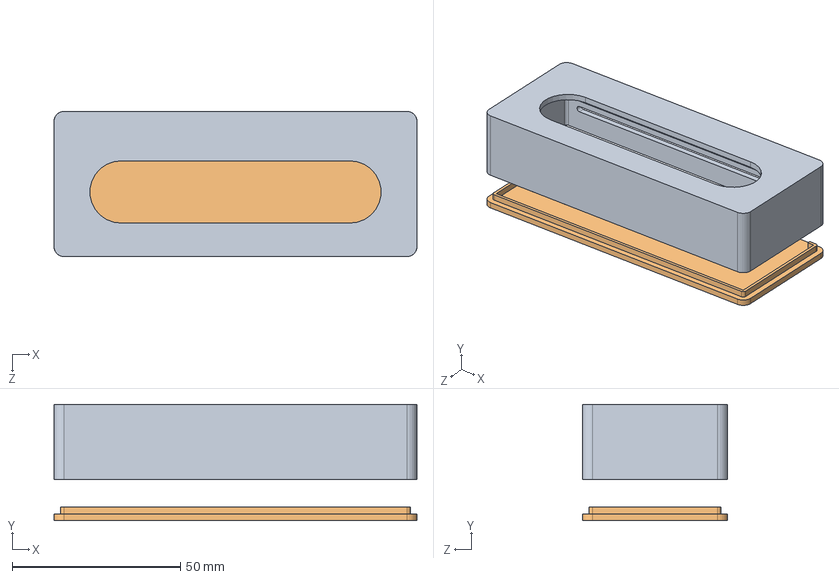
[picture p19: CAD file, 2025-11-15]
Inspo/IoT-nixie-clock-master/3DCase/CaseAssembly.SLDASM
108.0 x 34.6 x 43.2 mm
NixieCase1
NixieBase
