garvsify/Nixie-Valve-Clock/Electronic Resources and References/Buzzer Files/Same_Sky_CMI-1271-85-SMT-TR/Same_Sky_CMI-1271-85-SMT-TR.step

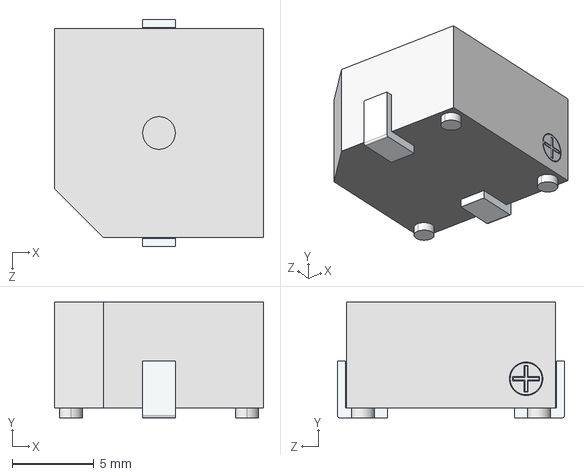
[picture p20: CAD file, 2025-12-01]
Electronic Resources and References/Buzzer Files/Same_Sky_CMI-1271-85-SMT-TR/Same_Sky_CMI-1271-85-SMT-TR.step
12.8 x 7.10 x 13.9 mm
