garvsify/Nixie-Valve-Clock/Electronic Resources and References/IN-14 Nixie Tube Resources/in-14-nixie-tube--step-model/NX-SZP-IN14-v01.STEP

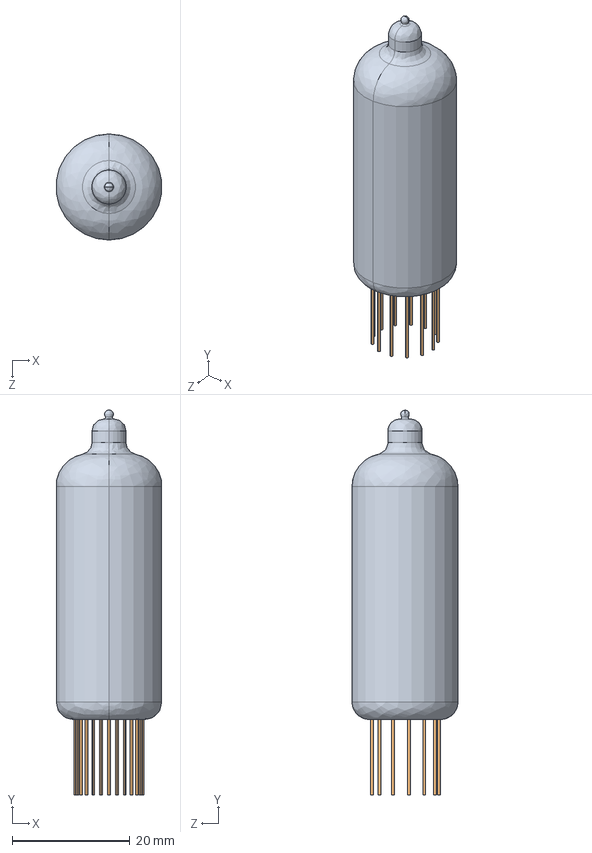
[picture p21: CAD file, 2025-12-01]
Electronic Resources and References/IN-14 Nixie Tube Resources/in-14-nixie-tube--step-model/NX-SZP-IN14-v01.STEP
17.9 x 65.3 x 18.0 mm
NX-SZP-IN14-10-v01_1
NX-SZP-IN14-11-v01_1 x 13
NX-SZP-IN14-12-v01_1
NX-SZP-IN14-13-v01_1
NX-SZP-IN14-14-v01_1
NX-SZP-IN14-15-v01_1
NX-SZP-IN14-16-v01_1
NX-SZP-IN14-17-v01_1
NX-SZP-IN14-18-v01_1 x 2
NX-SZP-IN14-00-v01_1
NX-SZP-IN14-01-v01_1
NX-SZP-IN14-02-v01_1
NX-SZP-IN14-03-v01_1
NX-SZP-IN14-04-v01_1
NX-SZP-IN14-05-v01_1
NX-SZP-IN14-06-v01_1
NX-SZP-IN14-07-v01_1
NX-SZP-IN14-08-v01_1
NX-SZP-IN14-09-v01_1
NX-SZP-IN14-19-v01_1
NX-SZP-IN14-20-v01_1
NX-SZP-IN14-21-v01_1
NX-SZP-IN14-21-v02_1
