garvsify/Nixie-Valve-Clock/Electronic Resources and References/Rotary Encoder/c-4-1879314-5-bb-3d.stp

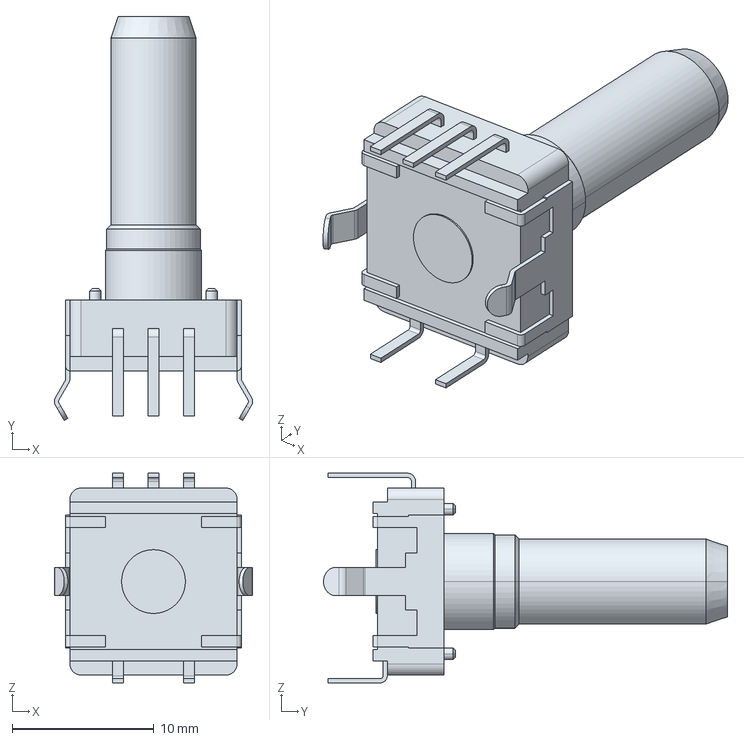
[picture p22: CAD file, 2025-12-01]
Electronic Resources and References/Rotary Encoder/c-4-1879314-5-bb-3d.stp
14.0 x 28.5 x 14.8 mm
