garvsify/Nixie-Valve-Clock/Fusion Design Files/Nixie Tube Clock.step

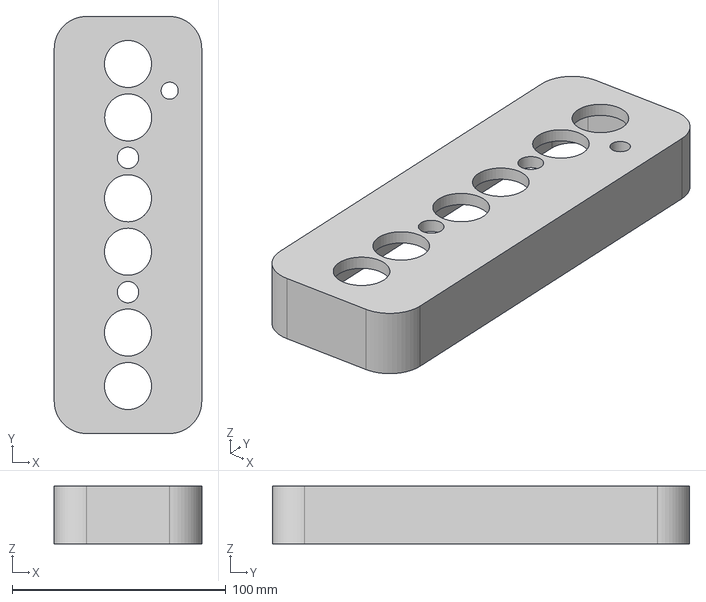
[picture p23: CAD file, 2025-11-15]
Fusion Design Files/Nixie Tube Clock.step
69.0 x 195.0 x 27.0 mm
