garvsify/Nixie-Valve-Clock/Electronic Resources and References/IN-14 Nixie Tube Resources/in-14-nixie-tube--step-model/User Library-IN-14-1.step

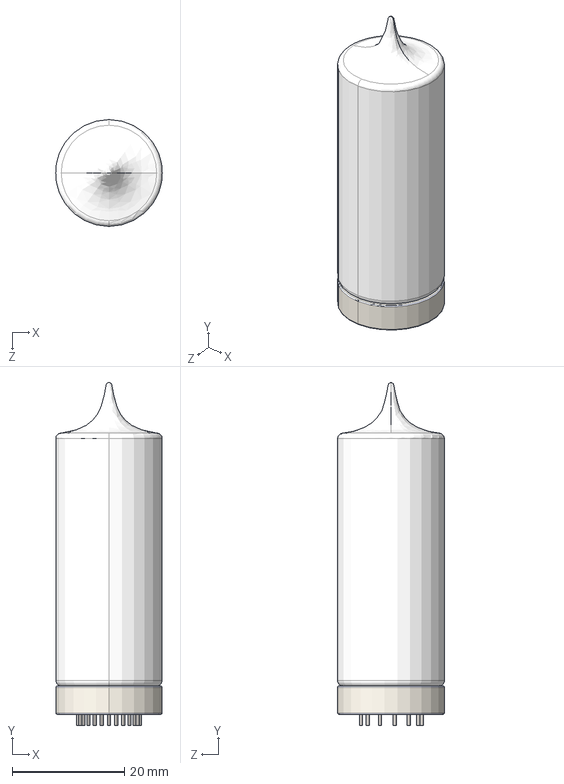
[picture p24: CAD file, 2025-12-01]
Electronic Resources and References/IN-14 Nixie Tube Resources/in-14-nixie-tube--step-model/User Library-IN-14-1.step
18.9 x 61.0 x 19.0 mm
