garvsify/Nixie-Valve-Clock/Inspo/IoT-nixie-clock-master/3DCase/NixieCase1.SLDPRT

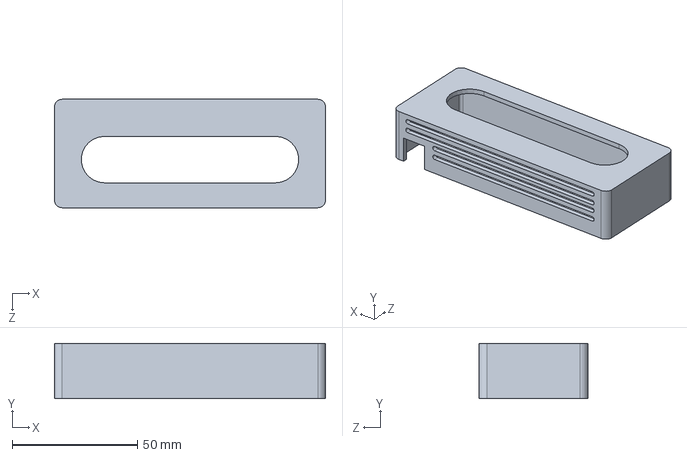
[picture p25: CAD file, 2025-11-15]
Inspo/IoT-nixie-clock-master/3DCase/NixieCase1.SLDPRT
108.0 x 22.0 x 43.2 mm
