garvsify/Nixie-Valve-Clock/Inspo/IoT-nixie-clock-master/3DCase/NixieBase.SLDPRT

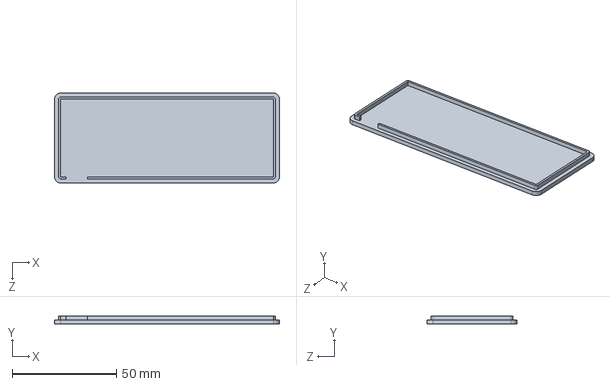
[picture p26: CAD file, 2025-11-15]
Inspo/IoT-nixie-clock-master/3DCase/NixieBase.SLDPRT
108.0 x 4.00 x 43.2 mm
