garvsify/Nixie-Valve-Clock/(list of files, cad)

Other CAD files:
Fusion Design Files/Nixie Tube Clock.f3d
Inspo/IoT-nixie-clock-master/3DCase/NixieBase.STL
Inspo/IoT-nixie-clock-master/3DCase/NixieCase1.SLDDRW
Inspo/IoT-nixie-clock-master/3DCase/NixieCase1.STL
