garvsify/Nixie-Valve-Clock/Electronic Resources and References/PCB Source Files/A.2-Release-(A.1-with-changes-documentation)/Nixie Valve Clock-A.2/SRC-Nixie Valve Clock-A.2/Documentation/PCB 3D Print/Nixie Valve Clock.png

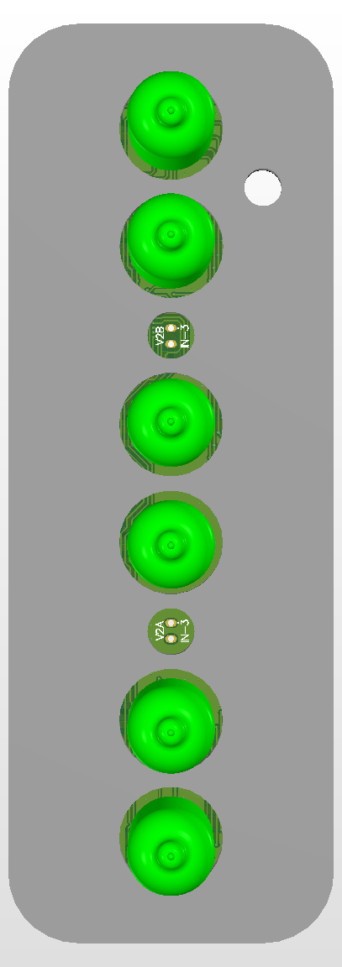
Electronic Resources and References/PCB Source Files/A.2-Release-(A.1-with-changes-documentation)/Nixie Valve Clock-A.2/SRC-Nixie Valve Clock-A.2/Documentation/PCB 3D Print/Nixie Valve Clock.png
