garvsify/Nixie-Valve-Clock/Electronic Resources and References/PCB Source Files/A.2-Release-(A.1-with-changes-documentation)/Power Supply DTB-A.2/SRC-Nixie Valve Clock Power Supply Daughterboard-A.2/Documentation/PCB 3D Print/Nixie Valve Clock Power Supply Daughterboard.png

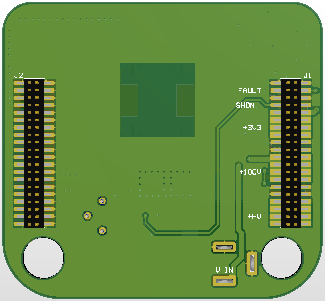
Electronic Resources and References/PCB Source Files/A.2-Release-(A.1-with-changes-documentation)/Power Supply DTB-A.2/SRC-Nixie Valve Clock Power Supply Daughterboard-A.2/Documentation/PCB 3D Print/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
