garvsify/Nixie-Valve-Clock/Electronic Resources and References/PCB Source Files/A.2-Release-(A.1-with-changes-documentation)/Nixie Valve Clock-A.2/SRC-Nixie Valve Clock-A.2/PCB Review Form.xlsx

 | PCB Review Sheet | Design Name: |  | Designer:
 |  | Design Revision: |  | Reviewer:
Check | Description | Designer Comment | Designer Conclusion | Reviewer Comment | Reviewer Conclusion
Schematic
ERC Pass | Design is free of ERC errors
Sensible symbols used for each component | Resistor symbol for resistors etc
Correct labels for all resistor components | All resistor components labelled with RefDes, voltage rating (if applicable), and package size
Correct labels for all capacitor components | All capacitor components labelled with RefDes, voltage rating, package size, ESR (optional), and ESL (optional)
Correct labels for all inductor components | As above.
No unessecery net name deviation | Net names are consistent with other designs where possible
Connector registration with other boards | Pin mapping with other boards has been checked
Design annotations included | The designer has added useful comments indicating the circuit function (such as "Gain=2")
RAC pass (have you considered derating?) | The design passes RAC analysis.
No high-Q ceramics for AC signal coupling
Capacitors maintaine sutable capacitance at working voltage | Have you used any cheap dielectrics?
Temperature stability considered
Power decoupling is appropriate | Suitable high and low frequency power decoupling has been included
Power nets connect to appropriate scope | Power nets may need to be global. Check that connections are made where you expect in your subsheets.
Every connection to uC has protection | Make sure there are protection components to every pin of uC that has any connections to the outside world.
Polarity, over voltage, and over current protection | Include where required
Use net classes to classify nets of shared type | Include where required
Use directives such as Generic No DRC (for NC pins), Parameter Set (to add nets to net classes), Differential Pair, etc. | Include where required
Ensure the components are annotated
Use hierachical design where appropriate | Use of Net Ports and Sheet Symbols can greatly simplify the design
Use the item manager to update components to their latest revision. | This will aid in cases where you have copied and pasted components from older projects.
BOM
No unecessary 0402 | 0402 components have not been used unless they are really needed.
No duplicate line items | No duplicate part values
No multicomp | Don't use Multicomp or RS branded components (they change the part randomly)
Layout
DRC check pass | No DRC errors
Space for screw head around fixing holes | A circle is included on the silk to indicate the space that the head of the screw will take up
Space for tool around fixing holes. | Space around fixing holes has been allowed for access to any nuts using an appropriate tool
No tracks under fixings | Tracks and copper do not go under fixing screw locations.
Board includes fixing holes | There are mounting holes
Stackup | The stackup is sensible, ideally matching the typical stackups provided by the manufacturer.
Thermal relief removed where appropriate | Thermal relief has been removed, or via stitching used for thermal management.
Teardropping used if needed
Robustify tracks to PTH components that may get reworked. | If you think you will need to rework a PTH part, put its track to the pad on the bottom of the board relative to the component so it does not get pulled off with rework. Or connect to both sides!
Design rules appropriate for manufacturer process
Appropriate ground connection to enclosure selected.
Via stitching is present
Space for mousebites | If the board will be panelised, make sure there is at least 2mm from the edge to any copper features in the mousebite locations. Indicate to the manufacturer where they can safely put these.
Silk
Logo aded | Company logo has been included
Design name added | The name of the design has been inlcuded on the board using the active field (not static text)
Design revision uses active field | The design revision has been included on the board using the active field (not static text)
Fiducials added
Serial number window | A window has been provided for recording the board serial number
Logo, design id and rev on both sides | This information should be duplicated on both sides of the board
CEM label position | A space has been allowed for any CEM lables such as serial numbers, or QC stickers.
Component Idents are legible | The idents. for each component are legible and not obstructed by vias
Useful silkscreen marks included | The layout includes useful silkscreen markings such as connector polarity/function, pin orders, jumper positions etc
