garvsify/Nixie-Valve-Clock/Simulations/Current Limiter for Nixie Clock.asc

D1: diode
M1: pmos; IRF9640
Q1: pnp; BC807-25
R1: res; 6R8
R2: res; 10k
R5: res; 390k
R6: res; 10k
V1: voltage; 180V; Rser=2
V2: voltage; 3.3; Rser=2
Named nets: 0, 180V, 3V3
.tran 0 0.1 0
