garvsify/Nixie-Valve-Clock/Simulations/LTSpice Simulation of Nixie Tube Anode and Cathode Drivers.asc

D2: zener; KDZLV110
Q1: npn; 2SC4061K
Q2: npn; 2SC4061K
Q3: npn; 2SC4061K
Q4: npn; 2SC4061K
Q5: npn; 2SC4061K
Q6: npn; 2SC4061K
Q7: npn; 2SC4061K
R1: res; 150k
R2: res; 100k
R3: res; 4.7k
R4: res; 4.7k
R5: res; 4.7k
R6: res; 4.7k
R7: res; 47k
R8: res; 130k
R9: res; 150k
R10: res; 100k
R11: res; 4.7k
R12: res; 4.7k
R13: res; 4.7k
R14: res; 130k
V1: voltage; 180
V2: voltage; 150V; Rser=2000
V3: voltage; 100
V4: voltage; 150V; Rser=2000
V5: voltage; PULSE(0 3.3 100n 10n 10n 500u 1000u 100)
Named nets: 180V, 0, 3.3V, 110V, SW, SW_INV
.tran 100m
NIXIE TUBE - 150V forward voltage with a large (actually non linear) internal resistance
NIXIE TUBE OFF
NIXIE TUBE - 150V forward voltage with a large (actually non linear) internal resistance
NIXIE TUBE ON
I will actually use a 100V zener, but LTSPice doesn't have one!
