garvsify/Nixie-Valve-Clock/(list of files, drawings)

Other design files:
Electronic Resources and References/PCB Source Files/A.2-Release-(A.1-with-changes-documentation)/Nixie Valve Clock-A.2/SRC-Nixie Valve Clock-A.2/IN-3 VALVE CATHODE DRIVER.SchDoc
Electronic Resources and References/PCB Source Files/A.2-Release-(A.1-with-changes-documentation)/Nixie Valve Clock-A.2/SRC-Nixie Valve Clock-A.2/IN-3 VALVE.SchDoc
Electronic Resources and References/PCB Source Files/A.2-Release-(A.1-with-changes-documentation)/Nixie Valve Clock-A.2/SRC-Nixie Valve Clock-A.2/IN-14 VALVE ANODE DRIVER.SchDoc
Electronic Resources and References/PCB Source Files/A.2-Release-(A.1-with-changes-documentation)/Nixie Valve Clock-A.2/SRC-Nixie Valve Clock-A.2/IN-14 VALVE CATHODE DRIVER.SchDoc
Electronic Resources and References/PCB Source Files/A.2-Release-(A.1-with-changes-documentation)/Nixie Valve Clock-A.2/SRC-Nixie Valve Clock-A.2/IN-14 VALVE x2.SchDoc
Electronic Resources and References/PCB Source Files/A.2-Release-(A.1-with-changes-documentation)/Nixie Valve Clock-A.2/SRC-Nixie Valve Clock-A.2/IN-14 VALVE.SchDoc
Electronic Resources and References/PCB Source Files/A.2-Release-(A.1-with-changes-documentation)/Nixie Valve Clock-A.2/SRC-Nixie Valve Clock-A.2/MCU.SchDoc
Electronic Resources and References/PCB Source Files/A.2-Release-(A.1-with-changes-documentation)/Nixie Valve Clock-A.2/SRC-Nixie Valve Clock-A.2/Nixie Valve Clock.PcbDoc
Electronic Resources and References/PCB Source Files/A.2-Release-(A.1-with-changes-documentation)/Nixie Valve Clock-A.2/SRC-Nixie Valve Clock-A.2/Nixie Valve Clock.PrjPcb
Electronic Resources and References/PCB Source Files/A.2-Release-(A.1-with-changes-documentation)/Nixie Valve Clock-A.2/SRC-Nixie Valve Clock-A.2/Nixie Valve Clock.SchDoc
Electronic Resources and References/PCB Source Files/A.2-Release-(A.1-with-changes-documentation)/Nixie Valve Clock-A.2/SRC-Nixie Valve Clock-A.2/VALVES.SchDoc
Electronic Resources and References/PCB Source Files/A.2-Release-(A.1-with-changes-documentation)/Power Supply DTB-A.2/SRC-Nixie Valve Clock Power Supply Daughterboard-A.2/HV.SchDoc
Electronic Resources and References/PCB Source Files/A.2-Release-(A.1-with-changes-documentation)/Power Supply DTB-A.2/SRC-Nixie Valve Clock Power Supply Daughterboard-A.2/Nixie Valve Clock Power Sup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
Electronic Resources and References/PCB Source Files/A.2-Release-(A.1-with-changes-documentation)/Power Supply DTB-A.2/SRC-Nixie Valve Clock Power Supply Daughterboard-A.2/Nixie Valve Clock Power Sup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
Electronic Resources and References/PCB Source Files/A.2-Release-(A.1-with-changes-documentation)/Power Supply DTB-A.2/SRC-Nixie Valve Clock Power Supply Daughterboard-A.2/Nixie Valve Clock Power Sup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
Electronic Resources and References/PCB Source Files/A.2-Release-(A.1-with-changes-documentation)/Power Supply DTB-A.2/SRC-Nixie Valve Clock Power Supply Daughterboard-A.2/POWER.SchDoc
Electronic Resources and References/PCB Source Files/A.2-Release-(A.1-with-changes-documentation)/Rotary Encoder DTB-A.2/SRC-Nixie Valve Clock Rotary Encoder Daughterboard-A.2/Nixie Valve Clock Rotar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
Electronic Resources and References/PCB Source Files/A.2-Release-(A.1-with-changes-documentation)/Rotary Encoder DTB-A.2/SRC-Nixie Valve Clock Rotary Encoder Daughterboard-A.2/Nixie Valve Clock Rotar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
Electronic Resources and References/PCB Source Files/A.2-Release-(A.1-with-changes-documentation)/Rotary Encoder DTB-A.2/SRC-Nixie Valve Clock Rotary Encoder Daughterboard-A.2/Nixie Valve Clock Rotar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
NUCLEO-G031K8 Files/MB1455C/MB1455.PcbDoc
NUCLEO-G031K8 Files/MB1455C/MB1455.PrjPcb
NUCLEO-G031K8 Files/MB1455C/MB1455_Top.SchDoc
NUCLEO-G031K8 Files/MB1455C/Mechanical.SchDoc
NUCLEO-G031K8 Files/MB1455C/Power.SchDoc
NUCLEO-G031K8 Files/MB1455C/Project_overview.SchDoc
NUCLEO-G031K8 Files/MB1455C/ST_LINK_V2-1.SCHDOC
NUCLEO-G031K8 Files/MB1455C/STM32G0_microcontroller.SchDoc
