garvsify/Nixie-Valve-Clock/Inspo/Nixieclock_kit-main/Nixie_proj.kicad_pcb

## KiCad design Inspo/Nixieclock_kit-main/Nixie_proj.kicad_pcb (2025-11-15)

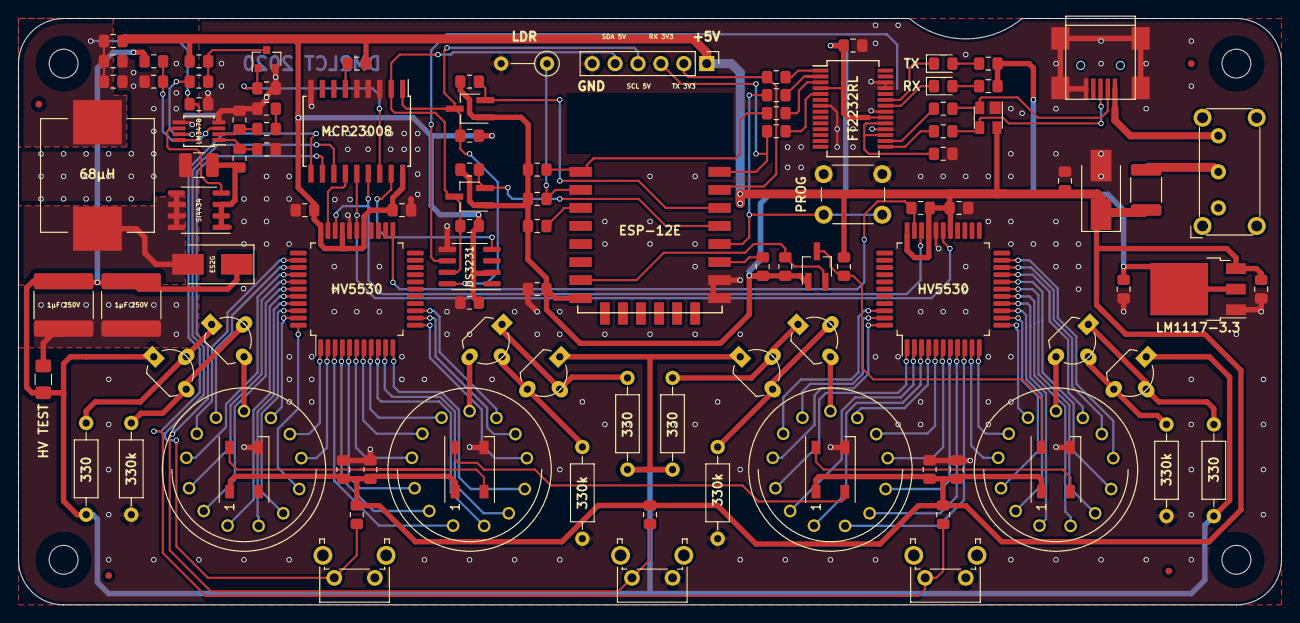
[picture p29: board Nixie_proj.kicad_pcb from above]

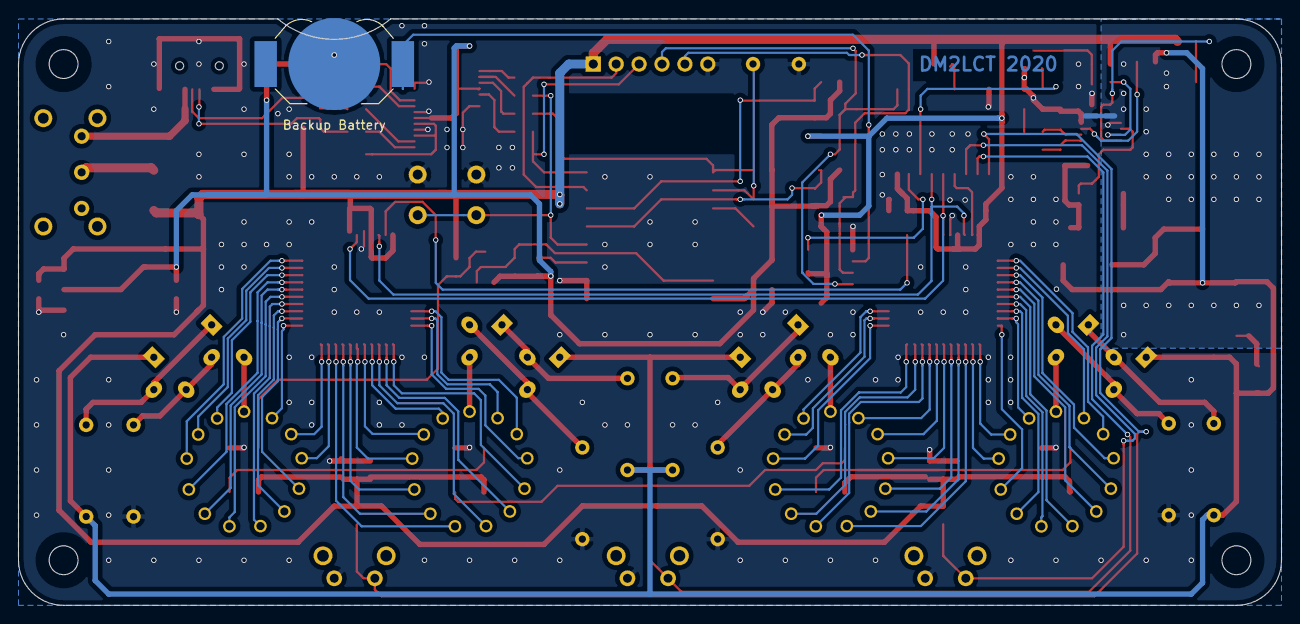
[picture p30: board Nixie_proj.kicad_pcb from below]

Board: 2 copper layers, 140.0 x 65.0 mm, 117 parts (2 on the bottom side), 117 nets.

Parts:
1µF 250V, 1µF 250V#2: 1u; C_2225_5664Metric_Pad1.80x6.60mm_HandSolder
68µH: INDUCTOR; L_Wuerth_WE-PD-Typ-LS_Handsoldering
330, 330#2, 330#3, 330#4: 330; R_Axial_DIN0207_L6.3mm_D2.5mm_P10.16mm_Horizontal
330k, 330k#2, 330k#3, 330k#4: 330k; R_Axial_DIN0207_L6.3mm_D2.5mm_P10.16mm_Horizontal
Backup Battery: Battery_Cell; BatteryHolder_LINX_BAT-HLD-012-SMT
C1, C5, C6, C8, C14, C16, C17, C18, C19, C20, C21, C22, C23, C201: 2.2u; C_0805_2012Metric_Pad1.15x1.40mm_HandSolder
C2, C3, C4: 22u; C_0805_2012Metric_Pad1.15x1.40mm_HandSolder
C7: 150p; C_0805_2012Metric_Pad1.15x1.40mm_HandSolder
C9: 1n; C_0805_2012Metric_Pad1.15x1.40mm_HandSolder
C305: 3n3; C_0805_2012Metric_Pad1.15x1.40mm_HandSolder
D1: P6SMB6,8A; D_SMB_Handsoldering
D2: PRTR5V0U2X; SOT-143
DS3231: DS3231MZ; SOIC-8_3.9x4.9mm_P1.27mm
ES2G: ES2G/SMB; D_SMB_Handsoldering
ESP-12E: ESP-12E; ESP-12E_SMD
F1: 2,2A; Fuse_1812_4532Metric_Pad1.30x3.40mm_HandSolder
FID1, FID2, FID3, FID4: Fiducial; Fiducial_0.75mm_Mask1.5mm
FT2232RL: FT232RL; SSOP-28_5.3x10.2mm_P0.65mm
H1, H2, H3: MountingHole; MountingHole_3.2mm_M3_DIN965
H4: eMountingHole; MountingHole_3.2mm_M3_DIN965
HV5530, HV5530#2: HV5530; MQFP-44_10x10mm_P0.8mm
HV TEST: TEST; R_1206_3216Metric_Pad1.42x1.75mm_HandSolder
J1: Conn_01x06_Male; PinHeader_1x06_P2.54mm_Vertical
L4: Ferrite_Bead; L_0805_2012Metric_Pad1.15x1.40mm_HandSolder
LDR: R_PHOTO; R_Axial_DIN0207_L6.3mm_D2.5mm_P5.08mm_Vertical
LED401, LED402, LED403, LED404: WS2812B; LED_WS2812B_PLCC4_5.0x5.0mm_P3.2mm
LM1117-3.3: LM1117-3.3; TO-252-3_TabPin2
LM3478: LM3478; MSOP-8_3x3mm_P0.65mm
MCP23008: MCP23008; SOIC-18W_7.5x11.6mm_P1.27mm
NT1: Net-Tie_2; NetTie-2_SMD_Pad0.5mm
P301: USB Buchse; USB_Mini-B
PROG: SW_Push; SW_PUSH_6mm_H4.3mm
Q2: BSS138; SOT-23
Q202, Q203, Q204, Q205, Q206, Q207, Q208, Q209: MPSA92; TO-92_Molded_Wide_Oval
Q401, Q403, Q404: BSS138; SOT-23W_Handsoldering
R1: 68k1; R_0805_2012Metric_Pad1.15x1.40mm_HandSolder
R2, R3, R206, R310, R401, R402, R403, R410, R411, R412, R413, R414, R416, R417, R418, R419, R420, R421: 10k; R_0805_2012Metric_Pad1.15x1.40mm_HandSolder
R4: 51k1; R_0805_2012Metric_Pad1.15x1.40mm_HandSolder
R5: 1k; R_0805_2012Metric_Pad1.15x1.40mm_HandSolder
R308: 1M5; R_0805_2012Metric_Pad1.15x1.40mm_HandSolder
R404, R405, R406, R407: 10R; R_0805_2012Metric_Pad1.15x1.40mm_HandSolder
R408, R409: 120; R_0805_2012Metric_Pad1.15x1.40mm_HandSolder
RSENSE301: 0R050; R_1210_3225Metric_Pad1.42x2.65mm_HandSolder
RX: GRÜN; LED_0805_2012Metric_Pad1.15x1.40mm_HandSolder
SI4434: SI4434; SOIC-8_3.9x4.9mm_P1.27mm
SW1: EG1224; SW_E-Switch_EG1224_SPDT_Angled
SW402: Rechts; SW_Tactile_SPST_Angled_PTS645Vx39-2LFS
SW403: Mitte; SW_Tactile_SPST_Angled_PTS645Vx39-2LFS
SW404: Links; SW_Tactile_SPST_Angled_PTS645Vx39-2LFS
TBE201, TBE202, TBE203, TBE204: IN14; IN-14-mod
TX: ROT; LED_0805_2012Metric_Pad1.15x1.40mm_HandSolder
W401, W402: TEST_2P; R_0805_2012Metric_Pad1.15x1.40mm_HandSolder

Connections:
+3V3: C6.1, C18.1, C21.2, ESP-12E.8, FT2232RL.4, FT2232RL.20, LM1117-3.3.2, Q401.1, Q403.1, Q404.1, R408.1, R409.1, R410.1, R412.1, R413.1, R414.1, R418.1, R419.1, R420.1
+5V: C1.1, C2.1, C5.1, C14.1, C16.1, C17.1, C20.1, C22.1, C23.2, C201.1, D1.1, D2.4, DS3231.2, F1.1, HV5530.27, HV5530.30, HV5530.33, HV5530#2.27, HV5530#2.30, HV5530#2.33, J1.1, L4.2, LED401.1, LED402.1, LED403.1, LED404.1, LM1117-3.3.3, MCP23008.18, R3.2, R206.1, R401.2, R402.2, R403.2, R411.1, R416.1, R417.1, R421.1
/Microcontroller and clock/BTN1: MCP23008.10, R401.1, SW402.2
/Microcontroller and clock/BTN2: MCP23008.11, R402.1, SW403.2
/Microcontroller and clock/BTN3: MCP23008.12, R403.1, SW404.2
/Microcontroller and clock/HVCLOCK: HV5530.28, HV5530#2.28, MCP23008.14
/Microcontroller and clock/HVDATA: HV5530.32, MCP23008.13
/Microcontroller and clock/HVSTROBE: HV5530.31, HV5530#2.31, MCP23008.15
/Microcontroller and clock/HV_SHDN: MCP23008.16, Q2.1, R2.2
/Microcontroller and clock/RX: ESP-12E.16, J1.3, R407.1
/Microcontroller and clock/SCL_3V3: ESP-12E.14, Q403.2, R413.2
/Microcontroller and clock/SCL_5V: DS3231.8, J1.4, MCP23008.1, Q403.3, R416.2
/Microcontroller and clock/SDA_3V3: ESP-12E.13, Q404.2, R412.2
/Microcontroller and clock/SDA_5V: DS3231.7, J1.5, MCP23008.2, Q404.3, R417.2
/Microcontroller and clock/TX: ESP-12E.15, J1.2, R406.1
/Microcontroller and clock/USBD+: D2.3, P301.3, R404.2
/Microcontroller and clock/USBD-: D2.2, P301.2, R405.2
/Power Supply/Boost_Drain: 68µH.2, ES2G.2, SI4434.5, SI4434.6, SI4434.7, SI4434.8
/Power Supply/Boost_ZK: 68µH.1, C3.1, C4.1, C8.2, L4.1, LM3478.8
/Power Supply/FB: LM3478.3, R308.2, R310.1
/Power Supply/Isen: C9.2, LM3478.1, R5.2
/Power Supply/PWRGND: 1µF 250V.2, 1µF 250V#2.2, C3.2, C4.2, HV TEST.2, LM3478.5, NT1.1, R310.2, RSENSE301.2
/Tubes with drivers/A0: HV5530.2, TBE201.11
/Tubes with drivers/A1: HV5530.35, TBE201.3
/Tubes with drivers/A2: HV5530.37, TBE201.4
/Tubes with drivers/A3: HV5530.38, TBE201.5
/Tubes with drivers/A4: HV5530.39, TBE201.6
/Tubes with drivers/A5: HV5530.40, TBE201.7
/Tubes with drivers/A6: HV5530.41, TBE201.8
/Tubes with drivers/A7: HV5530.42, TBE201.9
/Tubes with drivers/A8: HV5530.44, TBE201.10
/Tubes with drivers/A9: HV5530.1, TBE201.12
/Tubes with drivers/AC1: HV5530.36, TBE201.2
/Tubes with drivers/AC2: HV5530.43, TBE201.13
/Tubes with drivers/B0: HV5530.13, TBE202.12
/Tubes with drivers/B1: HV5530.5, TBE202.5
/Tubes with drivers/B2: HV5530.6, TBE202.4
/Tubes with drivers/B3: HV5530.7, TBE202.3
/Tubes with drivers/B4: HV5530.4, TBE202.6
/Tubes with drivers/B5: HV5530.3, TBE202.7
/Tubes with drivers/B6: HV5530.9, TBE202.8
/Tubes with drivers/B7: HV5530.10, TBE202.9
/Tubes with drivers/B8: HV5530.11, TBE202.10
/Tubes with drivers/B9: HV5530.12, TBE202.11
/Tubes with drivers/BC1: HV5530.8, TBE202.2
/Tubes with drivers/BC2: HV5530.14, TBE202.13
/Tubes with drivers/C0: HV5530#2.9, TBE203.8
/Tubes with drivers/C1: HV5530#2.42, TBE203.3
/Tubes with drivers/C2: HV5530#2.44, TBE203.4
/Tubes with drivers/C3: HV5530#2.1, TBE203.5
/Tubes with drivers/C4: HV5530#2.2, TBE203.6
/Tubes with drivers/C5: HV5530#2.3, TBE203.7
/Tubes with drivers/C6: HV5530#2.5, TBE203.12
/Tubes with drivers/C7: HV5530#2.6, TBE203.11
/Tubes with drivers/C8: HV5530#2.7, TBE203.10
/Tubes with drivers/C9: HV5530#2.8, TBE203.9
/Tubes with drivers/CC1: HV5530#2.43, TBE203.2
/Tubes with drivers/CC2: HV5530#2.4, TBE203.13
/Tubes with drivers/D0: HV5530#2.20, TBE204.12
/Tubes with drivers/D1: HV5530#2.11, TBE204.3
/Tubes with drivers/D2: HV5530#2.10, TBE204.4
/Tubes with drivers/D3: HV5530#2.13, TBE204.5
/Tubes with drivers/D4: HV5530#2.14, TBE204.6
/Tubes with drivers/D5: HV5530#2.15, TBE204.7
/Tubes with drivers/D6: HV5530#2.16, TBE204.8
/Tubes with drivers/D7: HV5530#2.17, TBE204.9
/Tubes with drivers/D8: HV5530#2.18, TBE204.10
/Tubes with drivers/D9: HV5530#2.21, TBE204.11
/Tubes with drivers/DC1: HV5530#2.12, TBE204.2
/Tubes with drivers/DC2: HV5530#2.19, TBE204.13
GND: 330k.2, 330k#2.2, 330k#3.2, 330k#4.2, Backup Battery.2, C1.2, C2.2, C5.2, C6.2, C7.2, C8.1, C9.1, C14.2, C16.2, C17.2, C18.2, C19.2, C20.2, C21.1, C22.2, C23.1, C201.2, D1.2, D2.1, DS3231.5, ESP-12E.9, ESP-12E.10, FT2232RL.7, FT2232RL.18, FT2232RL.21, FT2232RL.25, FT2232RL.26, HV5530.29, HV5530#2.29, J1.6, LDR.2, LED401.3, LED402.3, LED403.3, LED404.3, LM1117-3.3.1, LM3478.4, MCP23008.3, MCP23008.4, MCP23008.5, MCP23008.9, NT1.2, P301.5, P301.6, PROG.2, Q2.2, R1.2, R2.1, SW402.1, SW403.1, SW404.1
unnamed: Backup Battery.1, DS3231.6
unnamed: C19.1, FT2232RL.17, FT2232RL.19
unnamed: C7.1, C305.1, LM3478.2
unnamed: C305.2, R1.1
unnamed: FT2232RL.23, TX.1
unnamed: R408.2, TX.2
unnamed: FT2232RL.22, RX.1
unnamed: R409.2, RX.2
unnamed: F1.2, SW1.2
unnamed: LED401.4, LED402.2
unnamed: LED402.4, LED403.2
unnamed: LED403.4, LED404.2
unnamed: LED404.4, Q401.3, R411.2
unnamed: P301.1, SW1.3
unnamed: R5.1, RSENSE301.1, SI4434.1, SI4434.2, SI4434.3
unnamed: LM3478.6, SI4434.4
unnamed: Q2.3, R3.1, R4.2
unnamed: 330.2, Q202.2, Q203.1
unnamed: 330k.1, Q202.3, Q203.2
unnamed: Q203.3, TBE201.1
unnamed: 330#2.2, Q204.2, Q205.1
unnamed: 330k#2.1, Q204.3, Q205.2
unnamed: Q205.3, TBE202.1
unnamed: 330#3.2, Q206.2, Q207.1
unnamed: 330k#3.1, Q206.3, Q207.2
unnamed: Q207.3, TBE203.1
unnamed: 330#4.2, Q208.2, Q209.1
unnamed: 330k#4.1, Q208.3, Q209.2
unnamed: Q209.3, TBE204.1
unnamed: ESP-12E.7, Q401.2, R410.2
unnamed: LM3478.7, R4.1
unnamed: HV5530.23, HV5530#2.32, R206.2
unnamed: FT2232RL.15, R404.1
unnamed: FT2232RL.16, R405.1
unnamed: FT2232RL.1, R406.2
unnamed: FT2232RL.5, R407.2
unnamed: ESP-12E.2, LDR.1, R414.2
unnamed: ESP-12E.3, R418.2
unnamed: ESP-12E.1, R419.2, W401.2
unnamed: ESP-12E.11, R420.2
unnamed: MCP23008.6, R421.2
unnamed: ESP-12E.12, PROG.1, W402.2
unnamed: DS3231.4, MCP23008.17
unnamed: FT2232RL.2, W402.1
unnamed: FT2232RL.3, W401.1
VAA: 1µF 250V.1, 1µF 250V#2.1, 330.1, 330#2.1, 330#3.1, 330#4.1, ES2G.1, HV TEST.1, Q202.1, Q204.1, Q206.1, Q208.1, R308.1
