garvsify/Nixie-Valve-Clock/Inspo/IoT-nixie-clock-master/BoardFiles/BottomBoard/photonNixieBottom.brd

## EAGLE design Inspo/IoT-nixie-clock-master/BoardFiles/BottomBoard/photonNixieBottom.brd (2025-11-15)

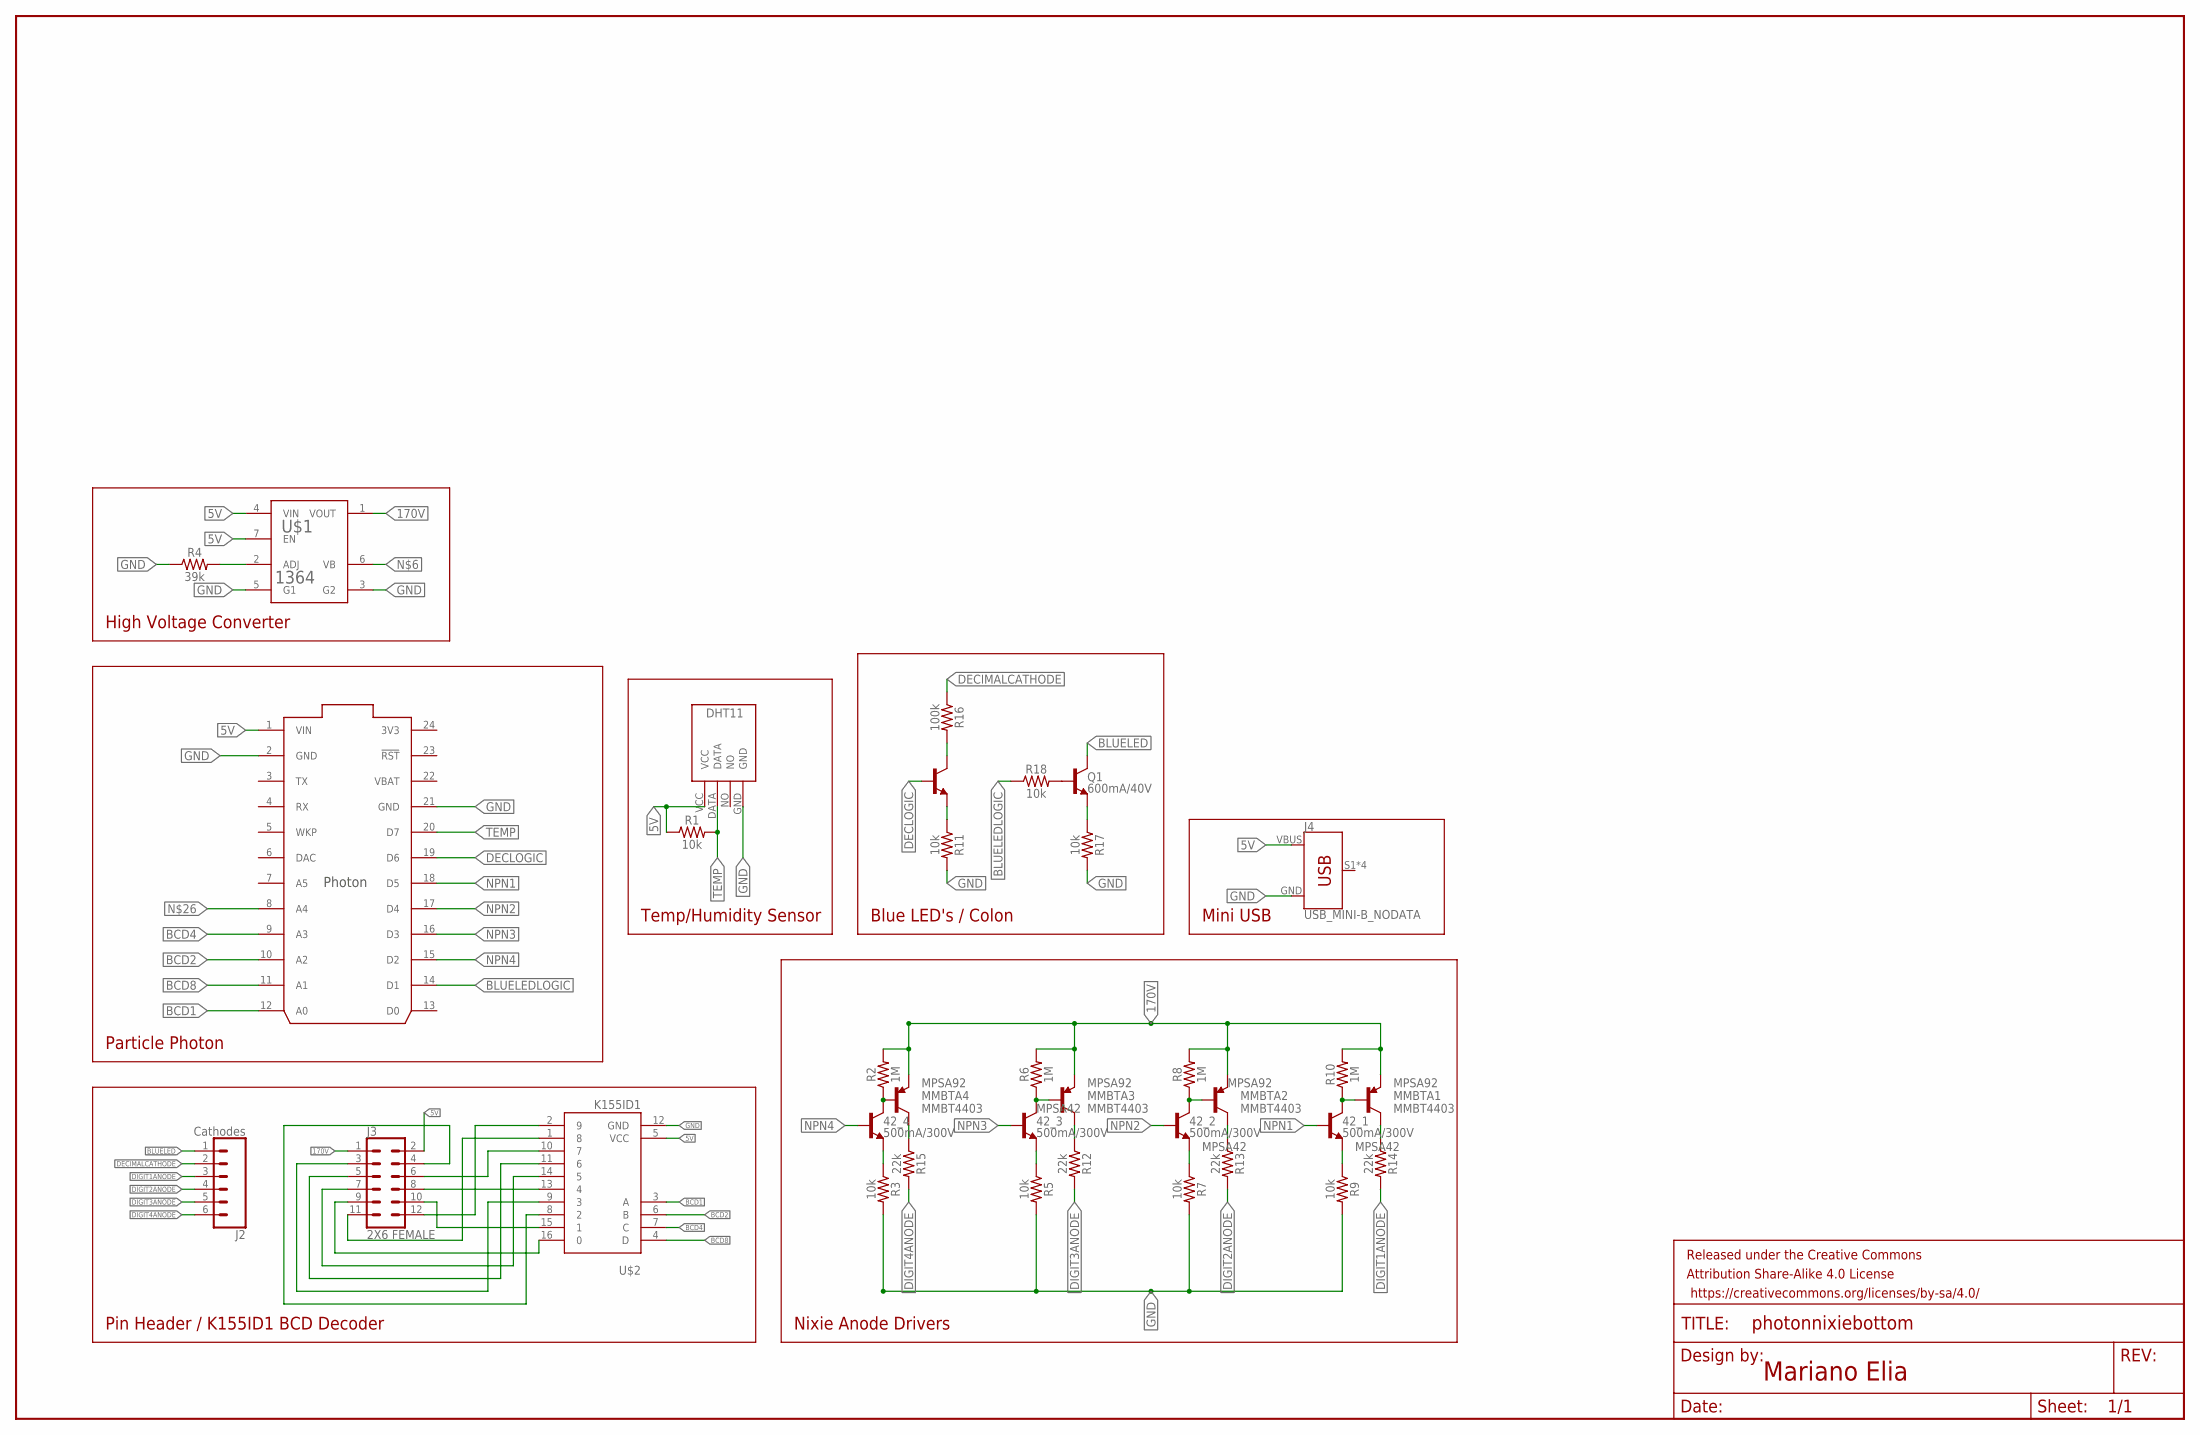
[picture p31: schematic photonNixieBottom.sch]

Parts:
42_1, 42_2, 42_3, 42_4: 500mA/300V; SOT23-3
FRAME1: FRAME-LEDGER; CREATIVE_COMMONS
J2: Cathodes; 1X06_NO_SILK
J3: 2X6 FEMALE; 2X6
J4: USB_MINI-B_NODATA; USB-MINIB_NODATA
MMBTA1, MMBTA2, MMBTA3, MMBTA4: MMBT4403; SOT23-3
MPSA7: 500mA/300V; SOT23-3
Q1: 600mA/40V; SOT23-3
R1, R3, R5, R7, R9, R11, R17, R18: 10k; 0805
R2, R6, R8, R10: 1M; 0805
R4: 39k; 0805
R12, R13, R14, R15: 22k; 0805
R16: 100k; 0805
U$1: 1364
U$2: K155ID1; DIL16-KIT
U$3: Temp/Humidity; DHT11
U$4: PHOTON_SMDNOSILK

Connections:
3V3: U$4.24 (3V3)
5V: J3.2, J4.VBUS, R1.1, U$1.4 (VIN), U$1.7 (EN), U$2.5 (VCC), U$3.VCC, U$4.1 (VIN)
170V: J3.1, MMBTA1.2 (E), MMBTA2.2 (E), MMBTA3.2 (E), MMBTA4.2 (E), R2.2, R6.2, R8.2, R10.2, U$1.1 (VOUT)
BCD1: U$2.3 (A), U$4.12 (A0)
BCD2: U$2.6 (B), U$4.10 (A2)
BCD4: U$2.7 (C), U$4.9 (A3)
BCD8: U$2.4 (D), U$4.11 (A1)
BLUELED: J2.1, Q1.3 (C)
BLUELEDLOGIC: R18.1, U$4.14 (D1)
DECIMALCATHODE: J2.2, R16.1
DECLOGIC: MPSA7.1 (B), U$4.19 (D6)
DIGIT1ANODE: J2.3, R14.2
DIGIT2ANODE: J2.4, R13.2
DIGIT3ANODE: J2.5, R12.2
DIGIT4ANODE: J2.6, R15.2
GND: J4.GND, R3.2, R4.1, R5.2, R7.2, R9.2, R11.2, R17.2, U$1.3 (G2), U$1.5 (G1), U$2.12 (GND), U$3.GND, U$4.2 (GND), U$4.21 (GND)
unnamed: J3.11, U$2.1 (8)
unnamed: J3.12, U$2.2 (9)
unnamed: R4.2, U$1.2 (ADJ)
unnamed: J3.9, U$2.16 (0)
unnamed: J3.10, U$2.15 (1)
unnamed: J3.7, U$2.14 (5)
unnamed: J3.8, U$2.13 (4)
unnamed: J3.5, U$2.11 (6)
unnamed: J3.6, U$2.10 (7)
unnamed: J3.3, U$2.9 (3)
unnamed: 42_4.2 (E), R3.1
unnamed: 42_3.2 (E), R5.1
unnamed: 42_4.3 (C), MMBTA4.1 (B), R2.1
unnamed: MPSA7.2 (E), R11.1
unnamed: 42_2.2 (E), R7.1
unnamed: 42_2.3 (C), MMBTA2.1 (B), R8.1
unnamed: J3.4, U$2.8 (2)
unnamed: 42_1.2 (E), R9.1
unnamed: 42_1.3 (C), MMBTA1.1 (B), R10.1
unnamed: 42_3.3 (C), MMBTA3.1 (B), R6.1
unnamed: MMBTA3.3 (C), R12.1
unnamed: MMBTA4.3 (C), R15.1
unnamed: MMBTA2.3 (C), R13.1
unnamed: MMBTA1.3 (C), R14.1
unnamed: MPSA7.3 (C), R16.2
unnamed: Q1.1 (B), R18.2
unnamed: Q1.2 (E), R17.1
NPN1: 42_1.1 (B), U$4.18 (D5)
NPN2: 42_2.1 (B), U$4.17 (D4)
NPN3: 42_3.1 (B), U$4.16 (D3)
NPN4: 42_4.1 (B), U$4.15 (D2)
TEMP: R1.2, U$3.DATA, U$4.20 (D7)
VBAT: U$4.22 (VBAT)

Notes on the sheet:
Particle Photon
Temp/Humidity Sensor
High Voltage Converter
Pin Header / K155ID1 BCD Decoder
Nixie Anode Drivers
Blue LED's / Colon
Mini USB
Mariano Elia

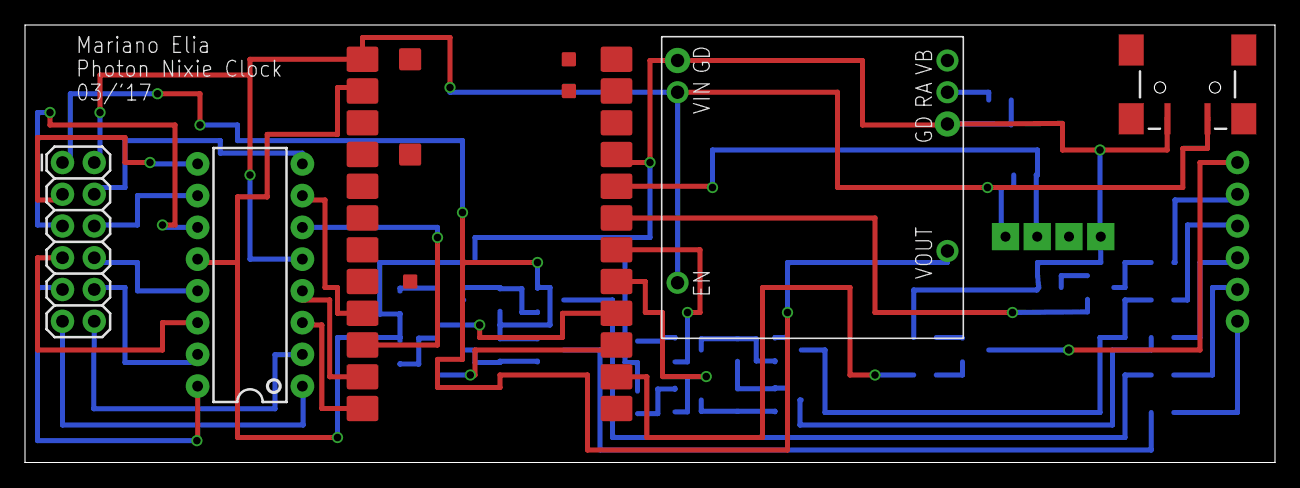
[picture p32: board photonNixieBottom.brd from above]

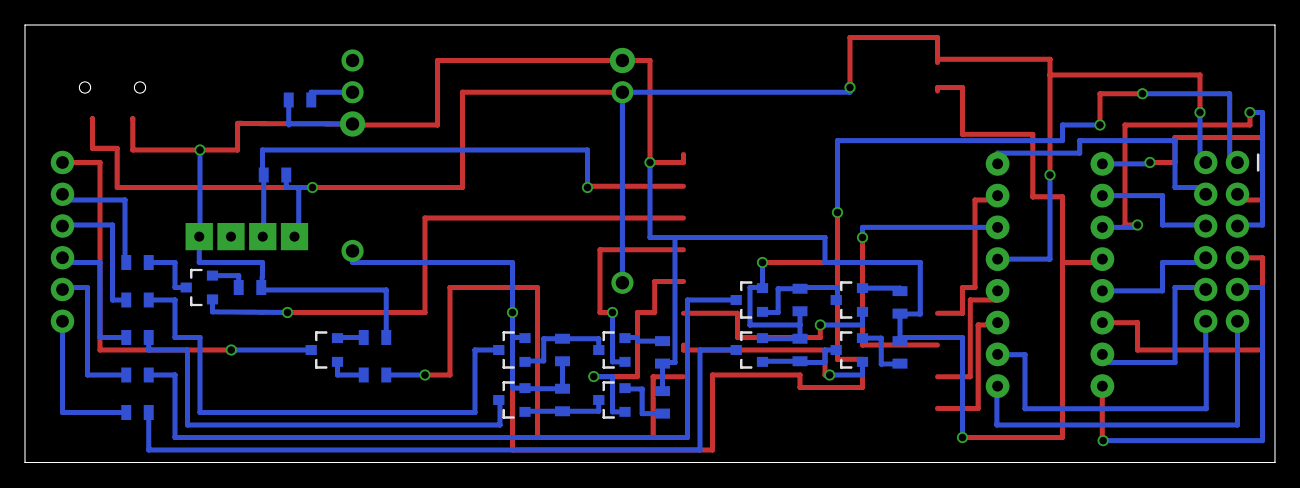
[picture p33: board photonNixieBottom.brd from below]

Board: 2 copper layers, 100.0 x 35.0 mm, 36 parts (28 on the bottom side), 47 nets.
