garvsify/Nixie-Valve-Clock/Inspo/IoT-nixie-clock-master/BoardFiles/TopBoard/photonNixieTop.brd

## EAGLE design Inspo/IoT-nixie-clock-master/BoardFiles/TopBoard/photonNixieTop.brd (2025-11-15)

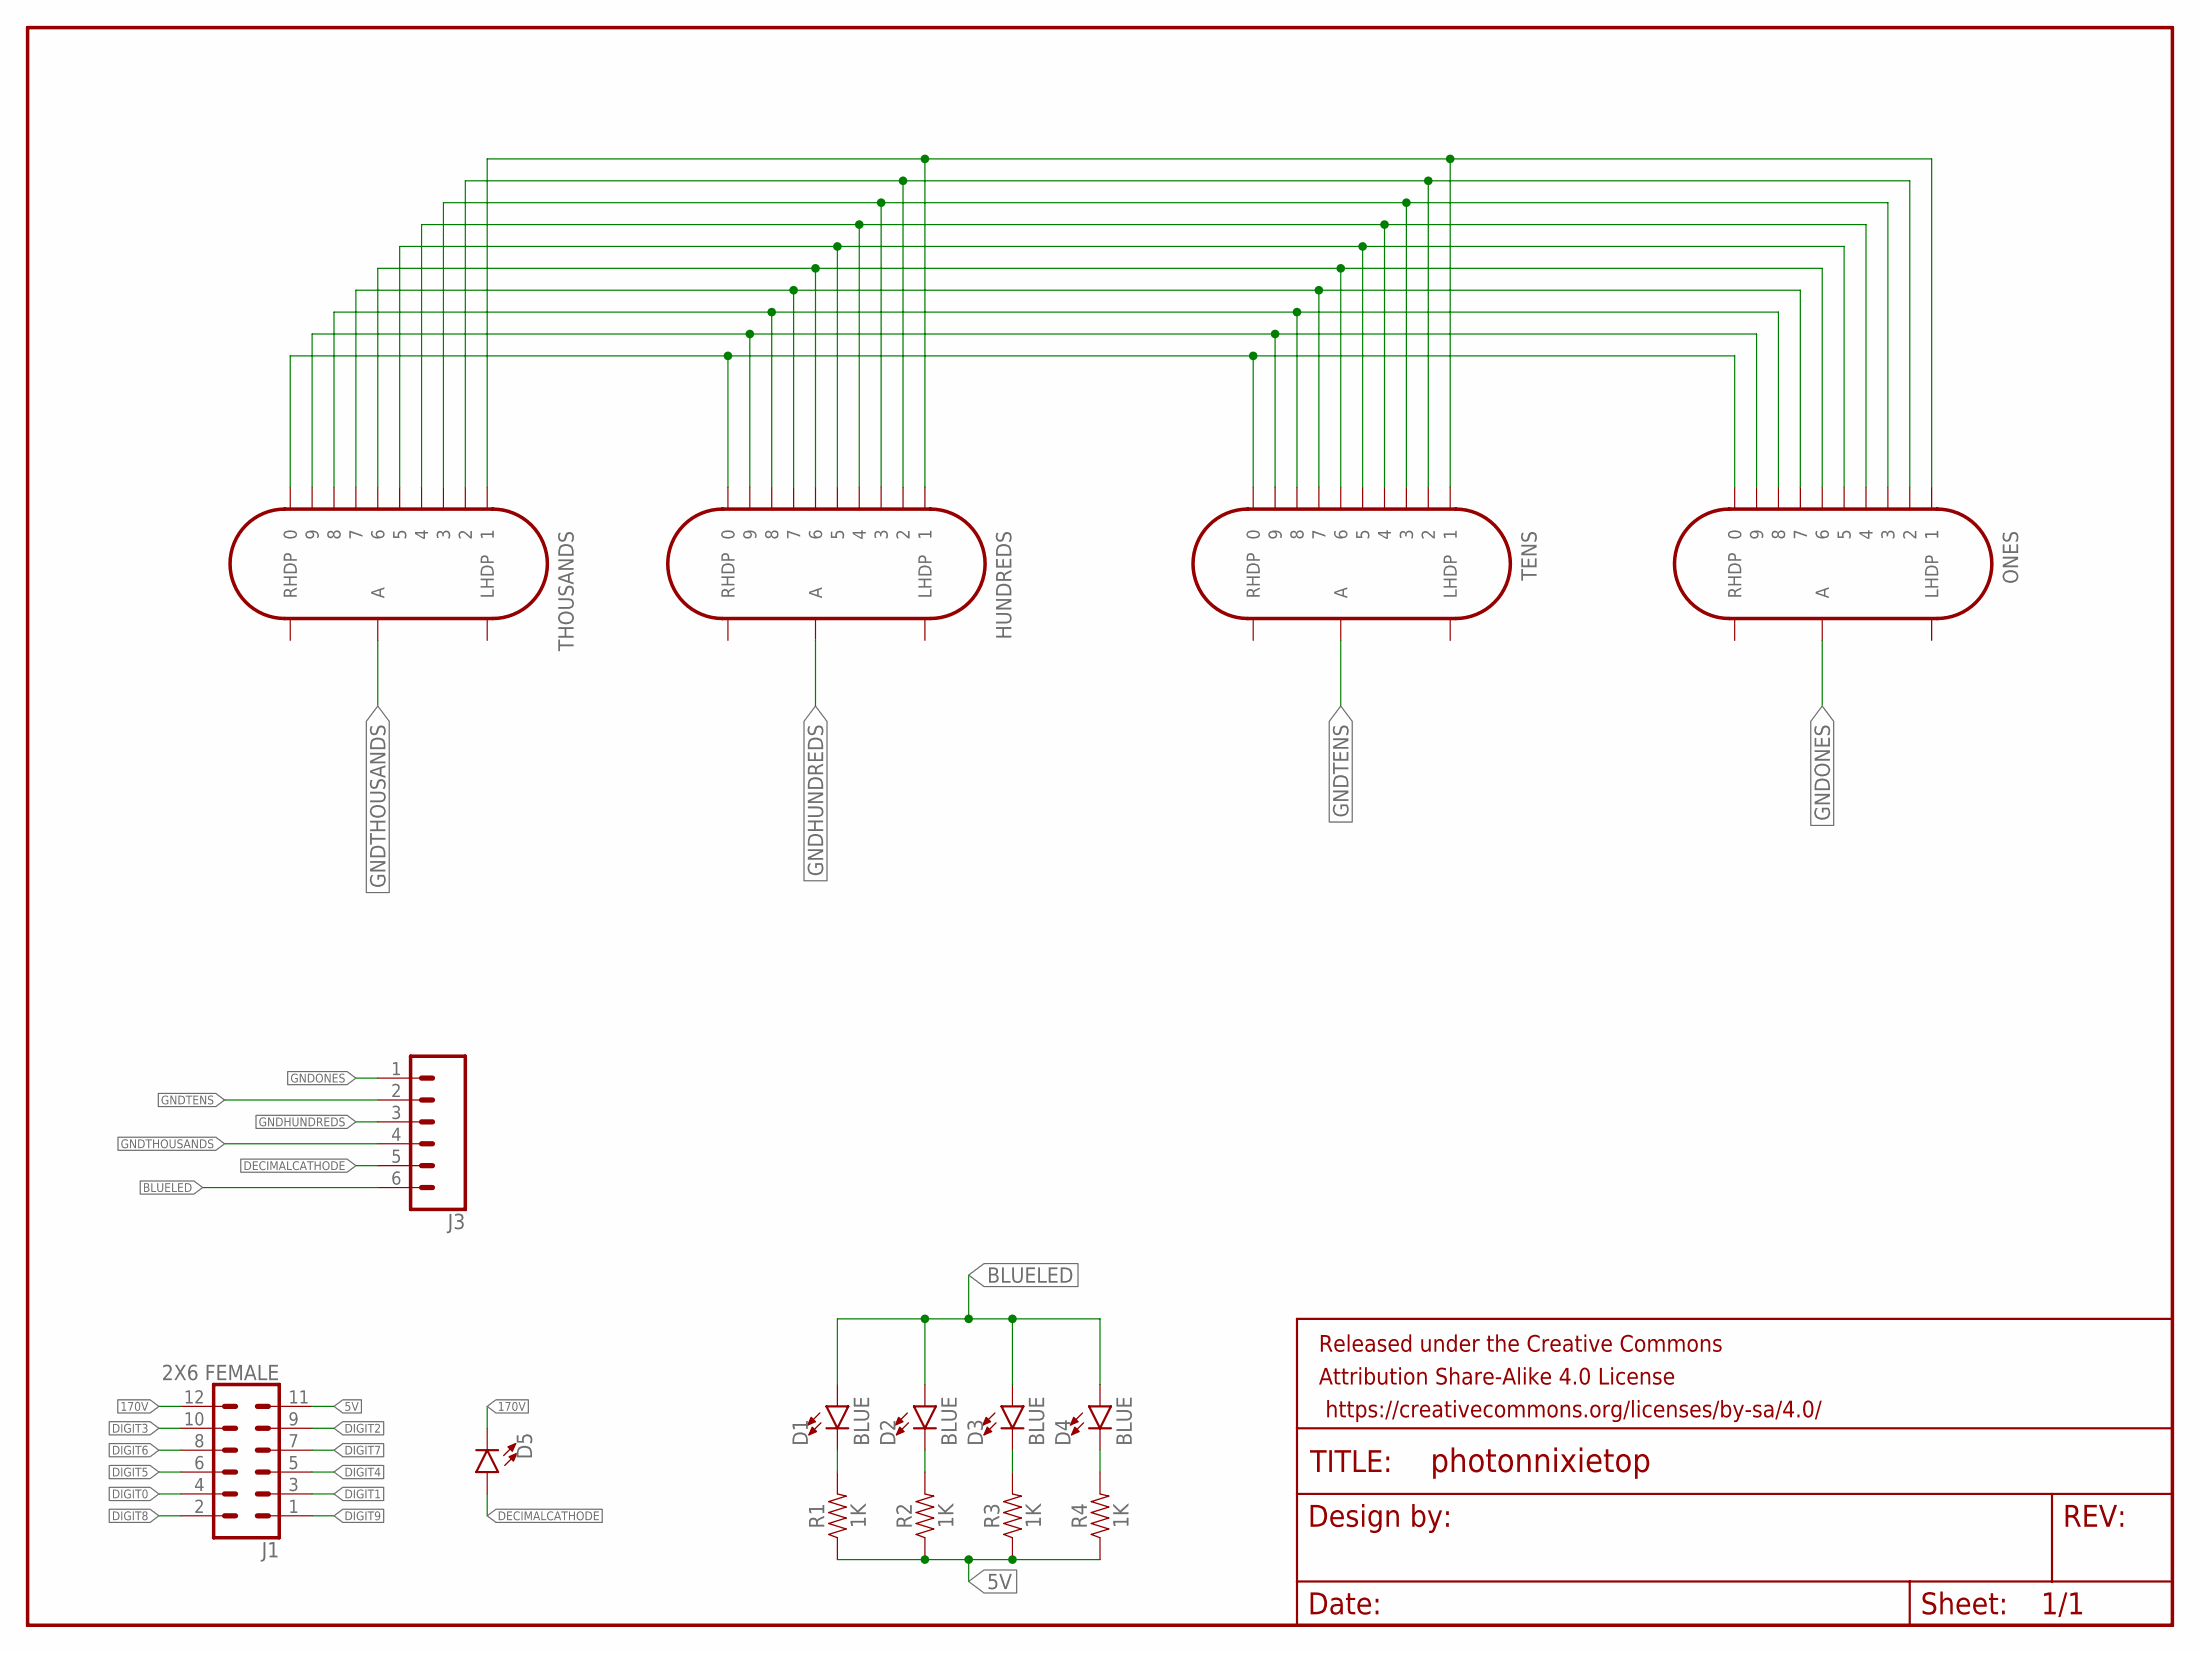
[picture p34: schematic photonNixieTop.sch]

Parts:
D1, D2, D3, D4: BLUE; LED-1206
D5: LED5MM; LED_5MM
FRAME1: FRAME-LETTER; CREATIVE_COMMONS
HUNDREDS: IN-14
J1: 2X6 FEMALE; 2X6
J3: CONN_06SILK_FEMALE_PTH; 1X06
ONES: IN-14
R1, R2, R3, R4: 1K; 0805
TENS: IN-14
THOUSANDS: IN-14

Connections:
5V: J1.11, R1.1, R2.1, R3.1, R4.1
170V: D5.K (C), J1.12
BLUELED: D1.A, D2.A, D3.A, D4.A, J3.6
DECIMALCATHODE: D5.A, J3.5
DIGIT0: HUNDREDS.0, J1.4, ONES.0, TENS.0, THOUSANDS.0
DIGIT1: HUNDREDS.1, J1.3, ONES.1, TENS.1, THOUSANDS.1
DIGIT2: HUNDREDS.2, J1.9, ONES.2, TENS.2, THOUSANDS.2
DIGIT3: HUNDREDS.3, J1.10, ONES.3, TENS.3, THOUSANDS.3
DIGIT4: HUNDREDS.4, J1.5, ONES.4, TENS.4, THOUSANDS.4
DIGIT5: HUNDREDS.5, J1.6, ONES.5, TENS.5, THOUSANDS.5
DIGIT6: HUNDREDS.6, J1.8, ONES.6, TENS.6, THOUSANDS.6
DIGIT7: HUNDREDS.7, J1.7, ONES.7, TENS.7, THOUSANDS.7
DIGIT8: HUNDREDS.8, J1.2, ONES.8, TENS.8, THOUSANDS.8
DIGIT9: HUNDREDS.9, J1.1, ONES.9, TENS.9, THOUSANDS.9
GNDHUNDREDS: HUNDREDS.A, J3.3
GNDONES: J3.1, ONES.A
GNDTENS: J3.2, TENS.A
GNDTHOUSANDS: J3.4, THOUSANDS.A
unnamed: D4.C, R4.2
unnamed: D3.C, R3.2
unnamed: D2.C, R2.2
unnamed: D1.C, R1.2

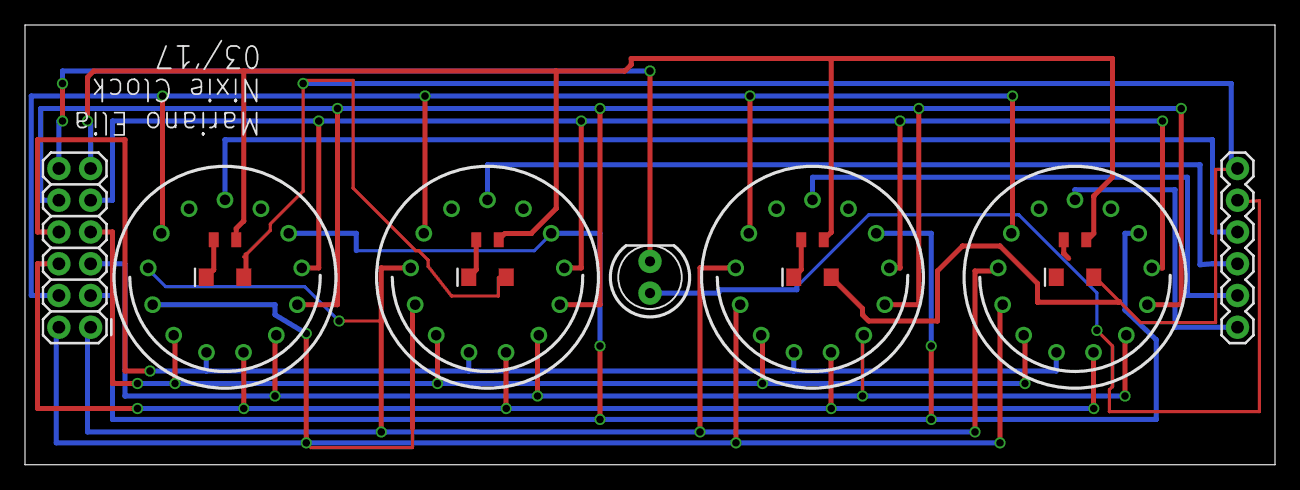
[picture p35: board photonNixieTop.brd from above]

Board: 2 copper layers, 100.0 x 35.2 mm, 16 parts (0 on the bottom side), 22 nets.
