garvsify/Nixie-Valve-Clock/Nixie-Valve-Clock-CubeMX-PWM-LEDs/Core/Src/custom_callbacks.c

#include "system.h"

void TIM17_Multiplexer_Sequencer_Callback(TIM_HandleTypeDef *htim){

	static uint8_t valve = 0;
	uint8_t BCD = 0;
	uint8_t valve_on = 0;

	Turn_All_Valves_Off(); // NEW: Ensure all valves are off at the start of each multiplex cycle, fixes bug, also means only have to
	//find cases below where valves are ON only

	for(uint32_t i = 0; i < master.dead_time; i++){

		asm("NOP");
	}

	if(master.system_mode_tracker.current_mode == VALVES_OFF_MODE){

		valve_on = 0;
	}
	else if(master.system_mode_tracker.current_mode == NORMAL_MODE){

		Get_RTC_Time();

		valve_on = 1;

		if(valve == 0){

			BCD = (master.get_time.Hours >> 4) & 0xF;
		}
		else if(valve == 1){

			BCD = master.get_time.Hours & 0xF;
		}
		else if(valve == 2){

			BCD = (master.get_time.Minutes >> 4) & 0xF;
		}
		else if(valve == 3){

			BCD = master.get_time.Minutes & 0xF;
		}
		else if(valve == 4){

			BCD = (master.get_time.Seconds >> 4) & 0xF;
		}
		else if(valve == 5){

			BCD = master.get_time.Seconds & 0xF;
		}
	}
	else if(master.system_mode_tracker.current_mode == ANTI_CATHODE_POISONING_MODE){

		valve_on = 1;

		BCD = master.anti_cathode_poisoning.counter & 0xF;
	}
	else if(master.system_mode_tracker.current_mode == HH_ADJUST_MODE || master.system_mode_tracker.current_mode == ALARM_SET_HH_MODE){

		if(valve == 0){

			if(master.valve_blink_state == 1){

				valve_on = 1;
			}
			if(master.system_mode_tracker.current_mode == HH_ADJUST_MODE){

				BCD = (master.time_adjust.adjust_time.Hours >> 4) & 0xF;
			}
			else if(master.system_mode_tracker.current_mode == ALARM_SET_HH_MODE){

				BCD = (master.alarm.alarm_time.Hours >> 4) & 0xF;
			}
		}
		else if(valve == 1){

			if(master.valve_blink_state == 1){

				valve_on = 1;
			}
			if(master.system_mode_tracker.current_mode == HH_ADJUST_MODE){

				BCD = master.time_adjust.adjust_time.Hours & 0xF;
			}
			else if(master.system_mode_tracker.current_mode == ALARM_SET_HH_MODE){

				BCD = master.alarm.alarm_time.Hours & 0xF;
			}
		}
		else if(valve == 2){

			valve_on = 1;

			if(master.system_mode_tracker.current_mode == HH_ADJUST_MODE){

				BCD = (master.time_adjust.adjust_time.Minutes >> 4) & 0xF;
			}
			else if(master.system_mode_tracker.current_mode == ALARM_SET_HH_MODE){

				BCD = (master.alarm.alarm_time.Minutes >> 4) & 0xF;
			}
		}
		else if(valve == 3){

			valve_on = 1;

			if(master.system_mode_tracker.current_mode == HH_ADJUST_MODE){

				BCD = master.time_adjust.adjust_time.Minutes & 0xF;
			}
			else if(master.system_mode_tracker.current_mode == ALARM_SET_HH_MODE){

				BCD = master.alarm.alarm_time.Minutes & 0xF;
			}
		}
		else if(valve == 4){

			valve_on = 1;

			if(master.system_mode_tracker.current_mode == HH_ADJUST_MODE){

				BCD = (master.time_adjust.adjust_time.Seconds >> 4) & 0xF;
			}
			else if(master.system_mode_tracker.current_mode == ALARM_SET_HH_MODE){

				BCD = (master.alarm.alarm_time.Seconds >> 4) & 0xF;
			}
		}
		else if(valve == 5){

			valve_on = 1;

			if(master.system_mode_tracker.current_mode == HH_ADJUST_MODE){

				BCD = master.time_adjust.adjust_time.Seconds & 0xF;
			}
			else if(master.system_mode_tracker.current_mode == ALARM_SET_HH_MODE){

				BCD = master.alarm.alarm_time.Seconds & 0xF;
			}
		}
	}
	else if(master.system_mode_tracker.current_mode == MM_ADJUST_MODE || master.system_mode_tracker.current_mode == ALARM_SET_MM_MODE){

		if(valve == 0){

			valve_on = 1;

			if(master.system_mode_tracker.current_mode == MM_ADJUST_MODE){

				BCD = (master.time_adjust.adjust_time.Hours >> 4) & 0xF;
			}
			else if(master.system_mode_tracker.current_mode == ALARM_SET_MM_MODE){

				BCD = (master.alarm.alarm_time.Hours >> 4) & 0xF;
			}
		}
		else if(valve == 1){

			valve_on = 1;

			if(master.system_mode_tracker.current_mode == MM_ADJUST_MODE){

				BCD = master.time_adjust.adjust_time.Hours & 0xF;
			}
			else if(master.system_mode_tracker.current_mode == ALARM_SET_MM_MODE){

				BCD = master.alarm.alarm_time.Hours & 0xF;
			}
		}
		else if(valve == 2){

			if(master.valve_blink_state == 1){

				valve_on = 1;
			}
			if(master.system_mode_tracker.current_mode == MM_ADJUST_MODE){

				BCD = (master.time_adjust.adjust_time.Minutes >> 4) & 0xF;
			}
			else if(master.system_mode_tracker.current_mode == ALARM_SET_MM_MODE){

				BCD = (master.alarm.alarm_time.Minutes >> 4) & 0xF;
			}
		}
		else if(valve == 3){

			if(master.valve_blink_state == 1){

				valve_on = 1;
			}
			if(master.system_mode_tracker.current_mode == MM_ADJUST_MODE){

				BCD = master.time_adjust.adjust_time.Minutes & 0xF;
			}
			else if(master.system_mode_tracker.current_mode == ALARM_SET_MM_MODE){

				BCD = master.alarm.alarm_time.Minutes & 0xF;
			}
		}
		else if(valve == 4){

			valve_on = 1;

			if(master.system_mode_tracker.current_mode == MM_ADJUST_MODE){

				BCD = (master.time_adjust.adjust_time.Seconds >> 4) & 0xF;
			}
			else if(master.system_mode_tracker.current_mode == ALARM_SET_MM_MODE){

				BCD = (master.alarm.alarm_time.Seconds >> 4) & 0xF;
			}
		}
		else if(valve == 5){

			valve_on = 1;

			if(master.system_mode_tracker.current_mode == MM_ADJUST_MODE){

				BCD = master.time_adjust.adjust_time.Seconds & 0xF;
			}
			else if(master.system_mode_tracker.current_mode == ALARM_SET_MM_MODE){

				BCD = master.alarm.alarm_time.Seconds & 0xF;
			}
		}
	}
	else if(master.system_mode_tracker.current_mode == SS_ADJUST_MODE || master.system_mode_tracker.current_mode == ALARM_SET_SS_MODE){

		if(valve == 0){

			valve_on = 1;

			if(master.system_mode_tracker.current_mode == SS_ADJUST_MODE){

				BCD = (master.time_adjust.adjust_time.Hours >> 4) & 0xF;
			}
			else if(master.system_mode_tracker.current_mode == ALARM_SET_SS_MODE){

				BCD = (master.alarm.alarm_time.Hours >> 4) & 0xF;
			}
		}
		else if(valve == 1){

			valve_on = 1;

			if(master.system_mode_tracker.current_mode == SS_ADJUST_MODE){

				BCD = master.time_adjust.adjust_time.Hours & 0xF;
			}
			else if(master.system_mode_tracker.current_mode == ALARM_SET_SS_MODE){

				BCD = master.alarm.alarm_time.Hours & 0xF;
			}
		}
		else if(valve == 2){

			valve_on = 1;

			if(master.system_mode_tracker.current_mode == SS_ADJUST_MODE){

				BCD = (master.time_adjust.adjust_time.Minutes >> 4) & 0xF;
			}
			else if(master.system_mode_tracker.current_mode == ALARM_SET_SS_MODE){

				BCD = (master.alarm.alarm_time.Minutes >> 4) & 0xF;
			}
		}
		else if(valve == 3){

			valve_on = 1;

			if(master.system_mode_tracker.current_mode == SS_ADJUST_MODE){

				BCD = master.time_adjust.adjust_time.Minutes & 0xF;
			}
			else if(master.system_mode_tracker.current_mode == ALARM_SET_SS_MODE){

				BCD = master.alarm.alarm_time.Minutes & 0xF;
			}
		}
		else if(valve == 4){

			if(master.valve_blink_state == 1){

				valve_on = 1;
			}
			if(master.system_mode_tracker.current_mode == SS_ADJUST_MODE){

				BCD = (master.time_adjust.adjust_time.Seconds >> 4) & 0xF;
			}
			else if(master.system_mode_tracker.current_mode == ALARM_SET_SS_MODE){

				BCD = (master.alarm.alarm_time.Seconds >> 4) & 0xF;
			}
		}
		else if(valve == 5){

			if(master.valve_blink_state == 1){

				valve_on = 1;
			}
			if(master.system_mode_tracker.current_mode == SS_ADJUST_MODE){

				BCD = master.time_adjust.adjust_time.Seconds & 0xF;
			}
			else if(master.system_mode_tracker.current_mode == ALARM_SET_SS_MODE){

				BCD = master.alarm.alarm_time.Seconds & 0xF;
			}
		}
	}

	if(valve_on){

		Write_Digit_to_Valve(valve, BCD);
	}

	valve++;

	if(valve == NUM_VALVES){

		valve = 0;
	}


	if(master.system_mode_tracker.current_mode == NORMAL_MODE || (master.system_mode_tracker.current_mode == ANTI_CATHODE_POISONING_MODE && master.system_mode_tracker.previous_mode == NORMAL_MODE)){

		HAL_GPIO_WritePin(GPIO_Output_IN_3_0_GPIO_Port, GPIO_Output_IN_3_0_Pin, 1);
		HAL_GPIO_WritePin(GPIO_Output_IN_3_1_GPIO_Port, GPIO_Output_IN_3_1_Pin, 1);
	}
	else{

		HAL_GPIO_WritePin(GPIO_Output_IN_3_0_GPIO_Port, GPIO_Output_IN_3_0_Pin, 0);
		HAL_GPIO_WritePin(GPIO_Output_IN_3_1_GPIO_Port, GPIO_Output_IN_3_1_Pin, 0);
	}

	static uint16_t counter = 0;

	if(master.alarm.alarm_triggered == 1){

		__HAL_TIM_SET_COMPARE(&htim1, TIM_CHANNEL_1, triangle_wavetable[counter]);
		__HAL_TIM_SET_COMPARE(&htim1, TIM_CHANNEL_2, triangle_wavetable[counter]);
		__HAL_TIM_SET_COMPARE(&htim1, TIM_CHANNEL_3, triangle_wavetable[counter]);

		if(counter == TRI_WAVETABLE_SIZE - 1){

			counter = 0;
		}
		else{

			counter++;
		}
	}
	else{

		__HAL_TIM_SET_COMPARE(&htim1, TIM_CHANNEL_1, 0);
		__HAL_TIM_SET_COMPARE(&htim1, TIM_CHANNEL_2, 0);
		__HAL_TIM_SET_COMPARE(&htim1, TIM_CHANNEL_3, 0);
		counter = 0;
	}
}

void TIM16_Anti_Cathode_Poisoning_Callback(TIM_HandleTypeDef *htim){

	if(master.system_mode_tracker.current_mode != ANTI_CATHODE_POISONING_MODE){

		Set_System_Mode_and_Store_Previous_Mode(&master.system_mode_tracker, ANTI_CATHODE_POISONING_MODE);
	}

	else{

		master.anti_cathode_poisoning.counter++;
	}
	if((master.anti_cathode_poisoning.cycle == (master.anti_cathode_poisoning.max_cycles - 1))
			&& (master.anti_cathode_poisoning.counter == master.anti_cathode_poisoning.max_counter + 1)){ //final cycle and final count + 1

		//Write_Time_In_Flash((RTC_TimeTypeDef*)&master.get_time);

		__HAL_TIM_SET_AUTORELOAD(&htim16, ANTI_CATHODE_POISONING_TIMER_WAITING_MODE_PERIOD_MINUS_ONE);
		__HAL_TIM_SET_PRESCALER(&htim16, ANTI_CATHODE_POISONING_TIMER_WAITING_MODE_PRESCALER);
		TIM16->EGR |= TIM_EGR_UG; //force an update event to transfer the preloaded registers into the active registers
		TIM16->SR &= ~TIM_SR_UIF; //clear the update interrupt flag generated by forcing an update event

		Set_System_Mode_and_Store_Previous_Mode(&master.system_mode_tracker, master.system_mode_tracker.previous_mode); //anti cathode poisoning
		//mode over, return to previous mode

		master.anti_cathode_poisoning.counter = 0;
		master.anti_cathode_poisoning.cycle = 0;
	}
	else{

		__HAL_TIM_SET_AUTORELOAD(&htim16, ANTI_CATHODE_POISONING_TIMER_ACTIVE_MODE_PERIOD_MINUS_ONE);
		__HAL_TIM_SET_PRESCALER(&htim16, ANTI_CATHODE_POISONING_TIMER_ACTIVE_MODE_PRESCALER);
		TIM16->EGR |= TIM_EGR_UG; //force an update event to transfer the preloaded registers into the active registers
		TIM16->SR &= ~TIM_SR_UIF; //clear the update interrupt flag generated by forcing an update event

		if((master.anti_cathode_poisoning.counter == master.anti_cathode_poisoning.max_counter + 1)
				&& (master.anti_cathode_poisoning.cycle != (master.anti_cathode_poisoning.max_cycles - 1))){

			master.anti_cathode_poisoning.counter = 0;
			master.anti_cathode_poisoning.cycle++;
		}
	}
}

void TIM14_Valve_Blink_Callback(TIM_HandleTypeDef *htim){

	if(master.valve_blink_state == BLINK_OFF){

		master.valve_blink_state = BLINK_ON;
	}
	else{

		master.valve_blink_state = BLINK_OFF;
	}
}

void LPTIM1_Rotary_Encoder_Switch_Callback(LPTIM_HandleTypeDef *hlptim){

	Check_Rotary_Encoder_Switch_State(&master.rotary_encoder_switch_states);

	static uint64_t depressed_num = 0;
	static uint8_t time_adjust_mode_is_active = 0;
	static uint8_t alarm_set_mode_is_active = 0;

	if(master.rotary_encoder_switch_states.rotary_encoder_switch_state == ROTARY_ENCODER_SWITCH_STATE_NOT_DEPRESSED){

		if(time_adjust_mode_is_active == 0 && alarm_set_mode_is_active == 0 && master.alarm.alarm_triggered == 0){

			//enter time adjust mode
			if(depressed_num >= ROTARY_ENCODER_SWITCH_ENTER_SLASH_ADVANCE_TIME_ADJUST_MODE_COUNT_MIN
					&& depressed_num < ROTARY_ENCODER_SWITCH_ENTER_SLASH_ADVANCE_TIME_ADJUST_MODE_COUNT_MAX){

				time_adjust_mode_is_active = 1;
				Set_System_Mode_and_Store_Previous_Mode(&master.system_mode_tracker, HH_ADJUST_MODE);
				Start_Adjust_Time_Slash_Alarm_Set_Mode_Timer();
				master.time_adjust.adjust_time = master.get_time;
				master.time_adjust.Hours_Bin = RTC_Bcd2ToByte(master.time_adjust.adjust_time.Hours);
				master.time_adjust.Minutes_Bin = RTC_Bcd2ToByte(master.time_adjust.adjust_time.Minutes);
				master.time_adjust.Seconds_Bin = RTC_Bcd2ToByte(master.time_adjust.adjust_time.Seconds);

				Set_Adjust_Time_LED_ON();
			}
			else if(depressed_num >= SET_ALARM_COUNT_MIN
					&& depressed_num < SET_ALARM_COUNT_MAX){

				alarm_set_mode_is_active = 1;
				Set_System_Mode_and_Store_Previous_Mode(&master.system_mode_tracker, ALARM_SET_HH_MODE);
				Start_Adjust_Time_Slash_Alarm_Set_Mode_Timer();
				master.alarm.alarm_time = master.get_time;
				master.alarm.Hours_Bin = RTC_Bcd2ToByte(master.alarm.alarm_time.Hours);
				master.alarm.Minutes_Bin = RTC_Bcd2ToByte(master.alarm.alarm_time.Minutes);
				master.alarm.Seconds_Bin = RTC_Bcd2ToByte(master.alarm.alarm_time.Seconds);

				Set_Alarm_Set_LEDs_ON();
			}
			//cancel alarm
			else if((depressed_num >= CANCEL_ALARM_COUNT_MIN)
					&& (depressed_num < CANCEL_ALARM_COUNT_MAX) && (master.alarm.alarm_set == 1)){

				Clear_Alarm();
				master.leds.Double_Flash_Red_LED = 1;
			}
		}
		else if(time_adjust_mode_is_active == 1){

			//advance through HH:MM:SS
			if(depressed_num >= ROTARY_ENCODER_SWITCH_ENTER_SLASH_ADVANCE_TIME_ADJUST_MODE_COUNT_MIN
								&& depressed_num < ROTARY_ENCODER_SWITCH_ENTER_SLASH_ADVANCE_TIME_ADJUST_MODE_COUNT_MAX){

				if(master.system_mode_tracker.current_mode == HH_ADJUST_MODE){

					Set_System_Mode_and_Store_Previous_Mode(&master.system_mode_tracker, MM_ADJUST_MODE);
				}
				else if(master.system_mode_tracker.current_mode == MM_ADJUST_MODE){

					Set_System_Mode_and_Store_Previous_Mode(&master.system_mode_tracker, SS_ADJUST_MODE);
				}
				else if(master.system_mode_tracker.current_mode == SS_ADJUST_MODE){

					Set_System_Mode_and_Store_Previous_Mode(&master.system_mode_tracker, HH_ADJUST_MODE);
				}
			}
			else if(depressed_num >= ROTARY_ENCODER_SWITCH_SAVE_TIME_COUNT_MIN
					&& depressed_num < ROTARY_ENCODER_SWITCH_SAVE_TIME_COUNT_MAX){

				Set_System_Mode_and_Store_Previous_Mode(&master.system_mode_tracker, NORMAL_MODE);
				Stop_Adjust_Time_Slash_Alarm_Set_Mode_Timer();
				time_adjust_mode_is_active = 0;

				HAL_RTC_SetTime(&hrtc, (RTC_TimeTypeDef*)&master.time_adjust.adjust_time, RTC_FORMAT_BCD);
				Set_Adjust_Time_LED_OFF();
			}
		}
		else if(alarm_set_mode_is_active == 1){

			if(depressed_num >= SET_ALARM_ADVANCE_COUNT_MIN
					&& depressed_num < SET_ALARM_ADVANCE_COUNT_MAX){

				if(master.system_mode_tracker.current_mode == ALARM_SET_HH_MODE){

					Set_System_Mode_and_Store_Previous_Mode(&master.system_mode_tracker, ALARM_SET_MM_MODE);
				}
				else if(master.system_mode_tracker.current_mode == ALARM_SET_MM_MODE){

					Set_System_Mode_and_Store_Previous_Mode(&master.system_mode_tracker, ALARM_SET_SS_MODE);
				}
				else if(master.system_mode_tracker.current_mode == ALARM_SET_SS_MODE){

					Set_System_Mode_and_Store_Previous_Mode(&master.system_mode_tracker, ALARM_SET_HH_MODE);
				}
			}
			else if(depressed_num >= SET_ALARM_SAVE_COUNT_MIN
					&& depressed_num < SET_ALARM_SAVE_COUNT_MAX){

				Set_System_Mode_and_Store_Previous_Mode(&master.system_mode_tracker, NORMAL_MODE);
				Stop_Adjust_Time_Slash_Alarm_Set_Mode_Timer();
				alarm_set_mode_is_active = 0;

				Set_Alarm(master.alarm.alarm_time.Hours, master.alarm.alarm_time.Minutes, master.alarm.alarm_time.Seconds);
				Set_Alarm_Set_LEDs_OFF();

				master.alarm.alarm_set = 1;
			}
		}
		else if(master.alarm.alarm_triggered == 1){

			if(depressed_num >= CLEAR_ALARM_COUNT_MIN
				&& depressed_num < CLEAR_ALARM_COUNT_MAX){

				Clear_Alarm();
			}
		}

		depressed_num = 0;
	}
	else if(master.rotary_encoder_switch_states.rotary_encoder_switch_state == ROTARY_ENCODER_SWITCH_STATE_DEPRESSED){

		depressed_num++;
	}

	HAL_LPTIM_SetOnce_Start_IT(&hlptim1, LPTIM1_CCR_CHECK, LPTIM1_CCR_CHECK);
}

void HAL_GPIO_EXTI_Rising_Callback(uint16_t GPIO_Pin){

	//shutdown HV and turn on rotary encoder's red lED
	Toggle_HV_Power_Supply(0);
	Set_Fault_LED_ON();
}

void Alarm_Callback(RTC_HandleTypeDef *hrtc)
{
	master.alarm.alarm_triggered = 1;
}

void UART2_RX_Transfer_Complete_Callback(UART_HandleTypeDef *huart){

	uint8_t ok = 0;

	//check for command type
	if(master.RX_buffer[COMMAND_INDEX] == CHANGE_DEAD_TIME_COMMAND){

		master.dead_time = (uint16_t)(((uint32_t)master.RX_buffer[VALUE_INDEX] * DEAD_TIME_MAX) >> 8);

		ok = 1;
	}
	else if(master.RX_buffer[COMMAND_INDEX] == CHANGE_CALM_COMMAND){

		master.calibration.CALM = (uint16_t)(((uint32_t)master.RX_buffer[VALUE_INDEX] * CALM_MAX) >> 8);

		HAL_RTCEx_SetSmoothCalib(&hrtc, 32, master.calibration.CALP, master.calibration.CALM);

		ok = 1;
	}
	else if(master.RX_buffer[COMMAND_INDEX] == CHANGE_CALP_COMMAND){

		if(master.RX_buffer[VALUE_INDEX] == CALP_DECREASE_FREQUENCY){

			master.calibration.CALP = CALP_DECREASE_FREQUENCY;
			HAL_RTCEx_SetSmoothCalib(&hrtc, 32, master.calibration.CALP, master.calibration.CALM);
			ok = 1;
		}
		else if(master.RX_buffer[VALUE_INDEX] == CALP_INCREASE_FREQUENCY){

			master.calibration.CALP = CALP_INCREASE_FREQUENCY;
			HAL_RTCEx_SetSmoothCalib(&hrtc, 32, master.calibration.CALP, master.calibration.CALM);
			ok = 1;
		}
	}
	//load transmit buffer with response
	master.TX_buffer[RESPONSE_INDEX] = ok;

	//clear receive buffer
	master.RX_buffer[COMMAND_INDEX] = 0;
	master.RX_buffer[VALUE_INDEX] = 0;

	HAL_UART_Transmit_IT(&huart2, (uint8_t*)master.TX_buffer, RESPONSE_NUM_BYTES);
	HAL_UART_Receive_IT(&huart2, (uint8_t*)master.RX_buffer, COMMAND_PLUS_ARGUMENT_NUM_BYTES);
}

void UART2_TX_Transfer_Complete_Callback(UART_HandleTypeDef *huart){

}
