garvsify/Nixie-Valve-Clock/Nixie-Valve-Clock-CubeMX-PWM-LEDs/Core/Src/anti_cathode_poisoning.c

#include "system.h"

uint8_t Start_Anti_Cathode_Poisoning_Timer(void){

	__HAL_TIM_ENABLE_IT(&htim16, TIM_IT_UPDATE); //make sure overflow (update) interrupt is enabled for TIM16

	uint8_t ok = Start_OC_TIM(&htim16, TIM_CHANNEL_1);

	if(ok != HAL_OK){

		Error_Handler();
	}

	return ok;
}
