garvsify/Nixie-Valve-Clock/Nixie-Valve-Clock-CubeMX-PWM-LEDs/Core/Src/time.c

#include "system.h"

uint8_t Get_RTC_Time(void){

	HAL_RTC_GetTime(&hrtc, (RTC_TimeTypeDef*)&master.get_time, RTC_FORMAT_BCD);
	HAL_RTC_GetDate(&hrtc, (RTC_DateTypeDef*)&master.get_date, RTC_FORMAT_BCD);

	return 1;
}
