garvsify/Nixie-Valve-Clock/Nixie-Valve-Clock-CubeMX-PWM-LEDs/Core/Src/multiplexer.c

#include "system.h"

uint8_t Start_Multiplexer_Timer(void){

	__HAL_TIM_ENABLE_IT(&htim17, TIM_IT_UPDATE); //make sure overflow (update) interrupt is enabled for TIM17

	uint8_t ok = Start_OC_TIM(&htim17, TIM_CHANNEL_1);

	if(ok != HAL_OK){

		Error_Handler();
	}

	return ok;
}
