garvsify/Nixie-Valve-Clock/(commit log)

2025-11-15 Initial commit of files created so far
    [CaseAssembly.SLDASM, Nixie HV PSU MAX1771.brd, Nixie HV PSU MAX1771.sch, Nixie Tube Clock.f3d, Nixie Tube Clock.step, Nixie Tube Test Project.kicad_pcb, Nixie Tube Test Project.kicad_sch, NixieBase.SLDPRT]
2025-11-16 Created a new document for PWM'd LEDs and BUZZER. Need to update old GPIO CubeMX file for changed pinouts required by PWM CubeMX file
    [Nixie-Valve-Clock-CubeMX-PWM-LEDs.ioc]
2025-11-22 Produced BOMs
    [Nixie Valve Clock Power Supply Daughterboard_EUROCIRCUITS_BOM.xlsx, Nixie Valve Clock Rotary Encoder Daughterboard_EUROCIRCUITS_BOM.xlsx, Nixie Valve Clock_EUROCIRCUITS_BOM.xlsx]
2025-11-29 Added fab files for motherboard
    [Gerber X2 Files_Copper_Signal_Bot.gbr, Gerber X2 Files_Copper_Signal_Top.gbr, Gerber X2 Files_Drawing_1.gbr, Gerber X2 Files_Drillmap_1.gbr, Gerber X2 Files_Keep-out.gbr, Gerber X2 Files_Legend_Bot.gbr, Gerber X2 Files_Legend_Top.gbr, Gerber X2 Files_Mechanical_1.gbr]
2025-12-01 Finally got the project openable and buildable in stm32cubeide
2025-12-01 adding example project for RTC and restructured project repo
    [CaseAssembly.SLDASM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]
2025-12-01 Added datasheets and reformatted repo again
    [NX-SZP-IN14-v01.STEP, Nixie HV PSU MAX1771.brd, Nixie HV PSU MAX1771.sch, Same_Sky_CMI-1271-85-SMT-TR.step, User Library-IN-14-1.step, c-4-1879314-5-bb-3d.stp]
2025-12-05 Written a load of bits for time adjustment. Need to config using CubeMX another timer peripheral to blink the valves when HH, MM, or SS are being adjusted.
2025-12-05 moved everything into master struct, ready to do cubemx config for additional timer peripheral
2025-12-05 wrote period and prescaler for incoming timer
2025-12-08 We have lift off! Clock is ticking! Tested with one valve so far in single dig. seconds slot. Not tested anti-cathode poisoning or a lot else, just that the time is ticking.
    [MB1455.PcbDoc, MB1455.PrjPcb, MB1455_Top.SchDoc, Mechanical.SchDoc, Power.SchDoc, Project_overview.SchDoc, STM32G0_microcontroller.SchDoc, ST_LINK_V2-1.SCHDOC]
2025-12-08 Introducing cathode poisoning timer is causing some mad shit
2025-12-08 for sone reason tim16 interrupts stop unexpectedly
2025-12-09 stripped out the anti-cathode poisoning stuff to revuild from ground up as I'mlosing my mind. This build shows that I think setting the the mode to the previous mode was the problem. Not sure. At lea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
    [custom_callbacks.c, main.c, main.h]
2025-12-09 Figured out how to get these bloody timers to work properly. Need to keep them in auto-preload enable mode, and then force transfer using an update event from the preload register to the active regis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
2025-12-10 sorted timers out andplayed around with IN-3s, in the end I think they look better if you can find a clean one!
2025-12-10 POC for time adjust valve
2025-12-10 hmm can't get valve leds to work...
2025-12-10 Debugged PWM on TIM1 for Valve LEDs
2025-12-11 Trough a mixture of putting loads of functions in RAM and massively speeding up the multiplexer, I've sorted the issue with the digits being fucky when writing the time to FLASH
    [custom_callbacks.c, main.c, multiplexer.c]
2025-12-11 hmmm actually it's not fixed the issue, will look to see if it's to do with the vector table(?) not being stored in RAM? I think every other function that is needed for this is stored in RAM
    [multiplexer.c]
2025-12-14 nearly got time calibrated. looking at rotary encoderstuff too
2025-12-14 Set up LPTIM1 for checking rotary encoder switch state.
2025-12-16 noice, got a build that should be able to adjust the time with the rotayr encoder and the rotary encoder switch. Debugged on eval board. SHould also have the digit being editted blinking. Only things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
2025-12-16 Also weird bug when setting time, only when the time adjust timer is blinking the adjust valves do you get the valve 'before' the valve adjust valves glow in time with the time adjust timer more brig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
    [main.c]
2025-12-16 have decidedtoignore redled for nowand come back to it. Have found on scope that blink issue with valve intimeadjust modeis bevause of the valve_on variable, the duty cycle of the valve is chaanging 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
    [custom_callbacks.c, main.c, multiplexer.c]
2025-12-17 noice, both issues sorted with PWM on TIM3 CH3 and brighter blinking valve during time adjust
    [custom_callbacks.c, main.c, multiplexer.c]
2025-12-18 Managed to unfuck what AI did to my code, currently can't get alarm interrupt to trigger, hmm...
2025-12-18 tidied up LED setting
2025-12-19 Only thing left to do is white alarm LEDs!
2025-12-20 alarm has a bug where when cleared it stays on, hmmmm
    [main.c, multiplexer.c]
2025-12-20 think i've fixed the alarm clear issue
    [multiplexer.c]
2025-12-21 nice, got alarm cancel working. Will now make dead adjustable via uart, probs ppm adjustment too
2025-12-21 Can't seem to get UART callbacks working
2025-12-21 UART be workin now
2025-12-21 Written a UART (TX) Response, so you can see that a change you have implemented has been successfully applied (or not)
2025-12-21 added alarm fix back in
    [custom_callbacks.c, multiplexer.c]
2025-12-21 moved everything across multiple source files, too slow still in thisconfig, will try increasing drive strength with CALM = max and CALP = 0, but may then be too fast
    [LEDs.c, alarm.c, anti_cathode_poisoning.c, custom_callbacks.c, defines.h, flash.c, main.c, main.h]
2025-12-21 with 15pF for the C0G XTAL caps amfinding that either drive strength MEDIUMLOW or MEDIUMHIGH, and compensating with the CALP/CALM regs that either too fast/too slow even at the extremes, will have to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
    [defines.h, main.c]
2025-12-23 some tweaks to reduce noise whilst keeping switch depression lengths okay
    [defines.h]
2025-12-31 stil working on getting it to tick in time. Have also tweaked rotary encoder checking
2025-12-31 added new release with ammendements/documentation added, also including schematic and pcb prints
2025-12-31 unzipped A.2 release on a mac because windows is a lil bitch
    [Eurocircuits Class Calculator and Design Rule Generator.xlsx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]
2026-01-08 Finally debugged the rollover conditions (both over and under flows) for HH time adjust in this commit, will now transfer to Mins and Secs for time adjust and alarm adjust
